Borgesvpm/Amaze/Data visualization/189003_decision_timing_1.png

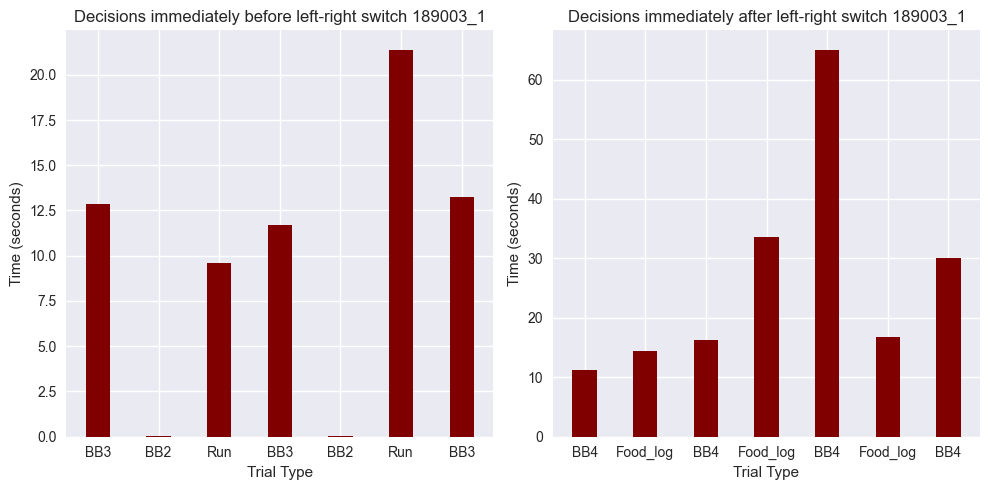
Data visualization/189003_decision_timing_1.png
