Borgesvpm/Amaze/Data visualization/189003_decision_timing_2.png

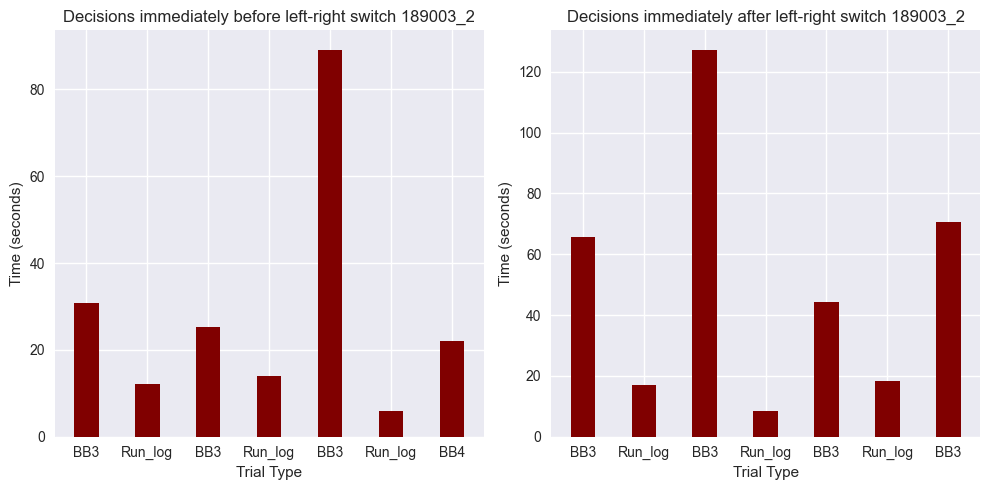
Data visualization/189003_decision_timing_2.png
