Borgesvpm/Amaze/Data visualization/189003_decision_timing_3.png

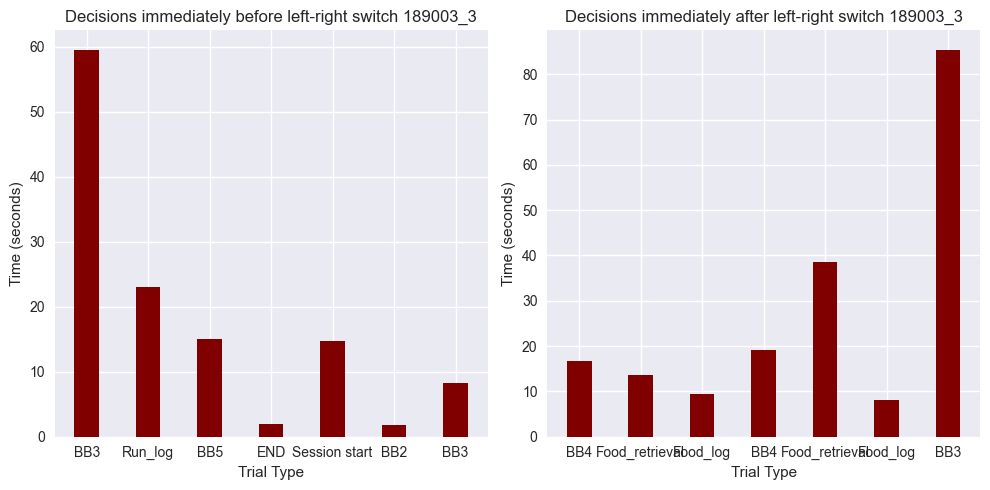
Data visualization/189003_decision_timing_3.png
