Borgesvpm/Amaze/Data visualization/189003_decision_timing_4.png

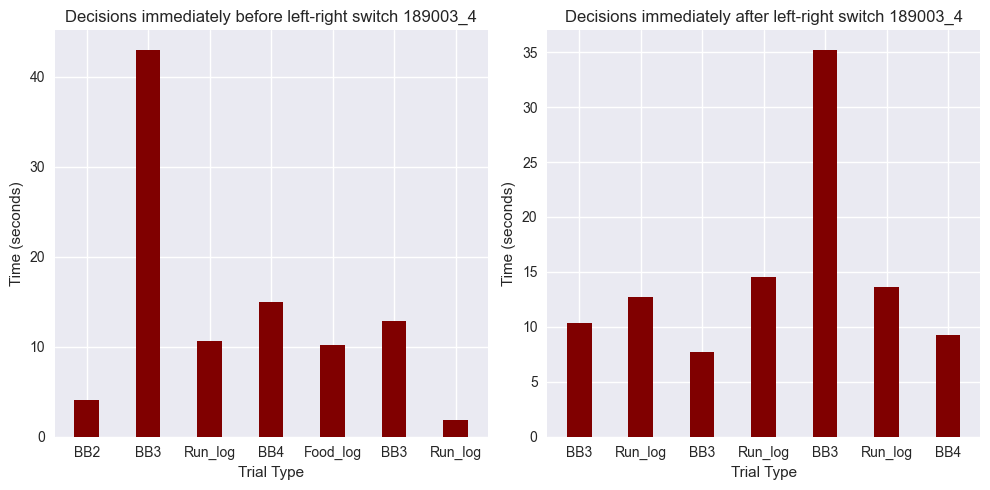
Data visualization/189003_decision_timing_4.png
