Borgesvpm/Amaze/Data visualization/189003_three_decisions.png

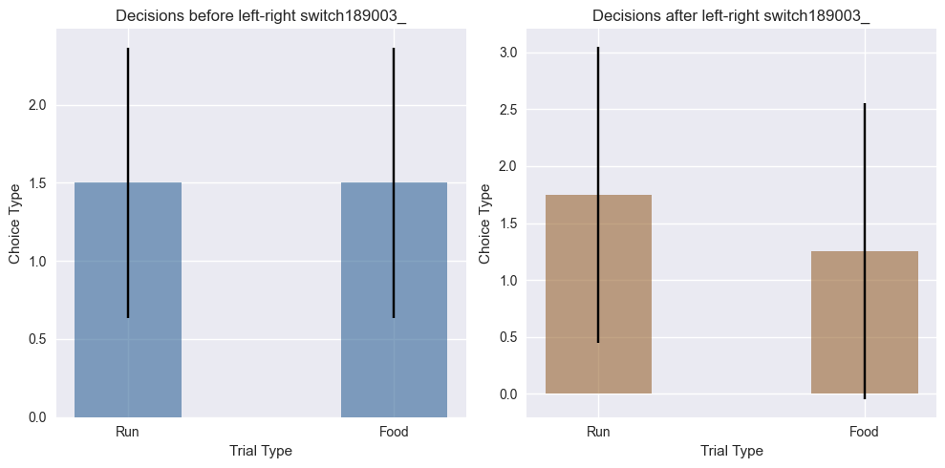
Data visualization/189003_three_decisions.png
