Borgesvpm/Amaze/Data visualization/189003_three_decisions_line.png

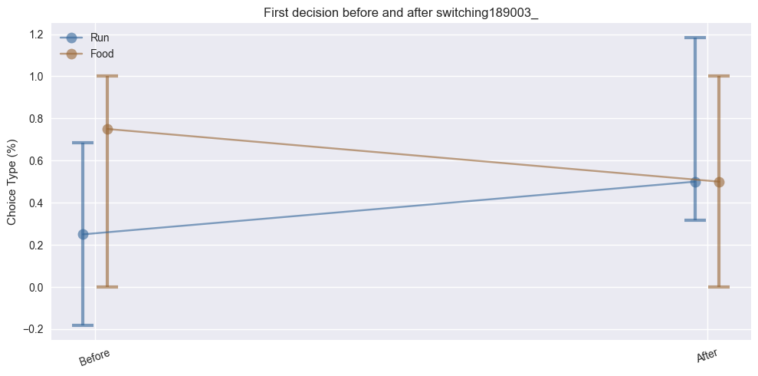
Data visualization/189003_three_decisions_line.png
