Borgesvpm/Amaze/Data visualization/189003_time_stats.png

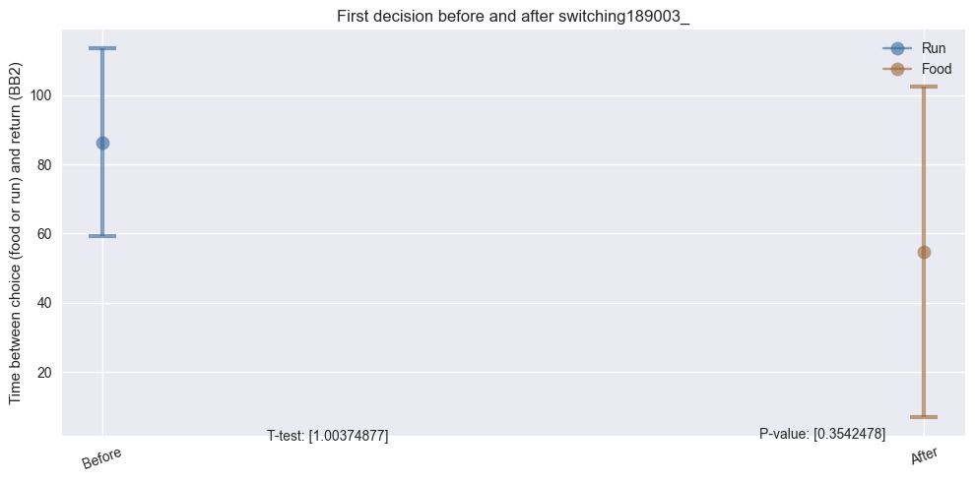
Data visualization/189003_time_stats.png
