Borgesvpm/Amaze/Data visualization/189003day_decision.png

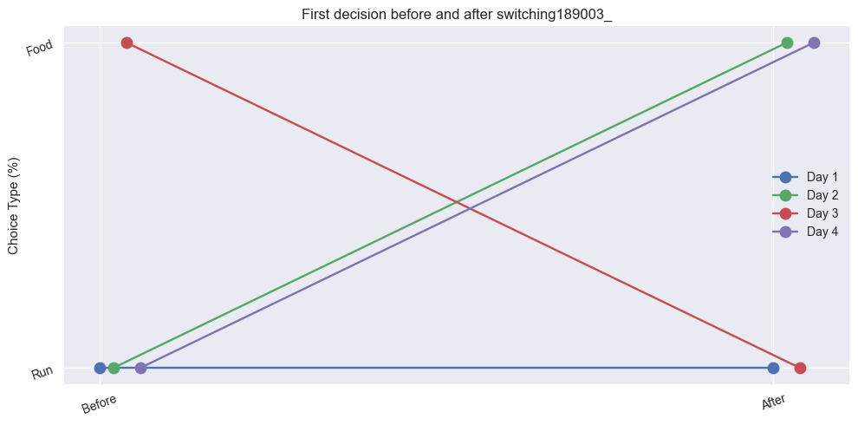
Data visualization/189003day_decision.png
