Borgesvpm/Amaze/Data visualization/189003day_decision_time.png

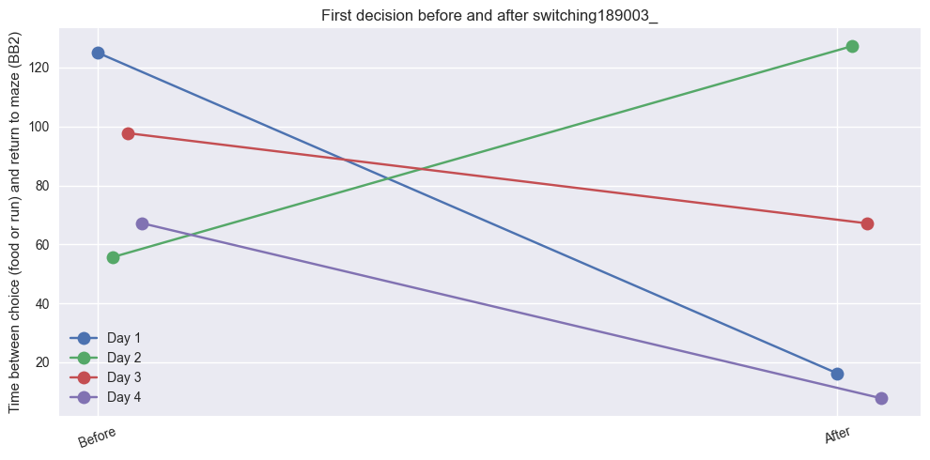
Data visualization/189003day_decision_time.png
