Borgesvpm/Amaze/Data visualization/189004_decision_timing_1.png

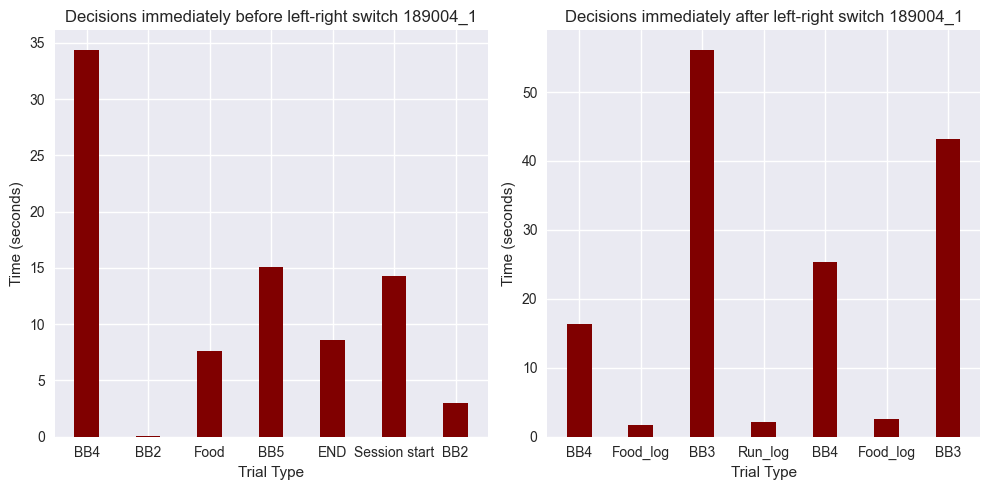
Data visualization/189004_decision_timing_1.png
