Borgesvpm/Amaze/Data visualization/189004_decision_timing_2.png

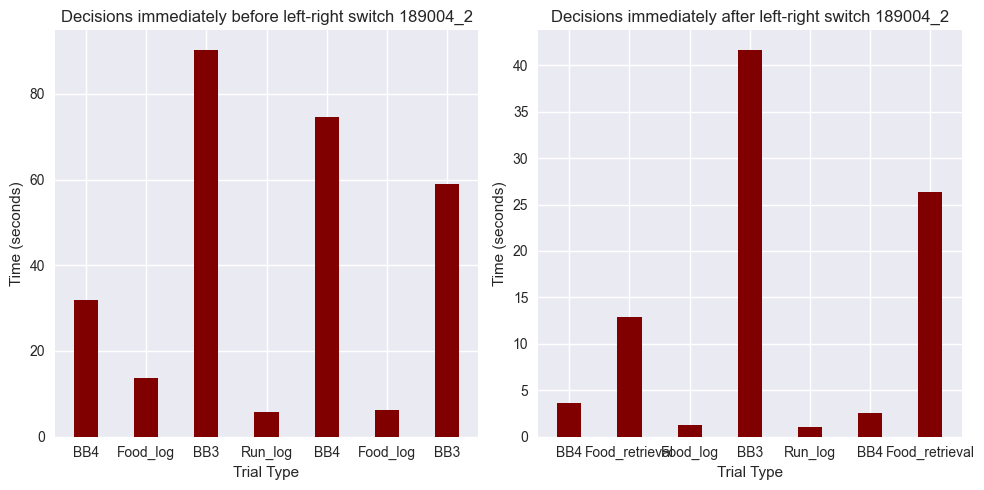
Data visualization/189004_decision_timing_2.png
