Borgesvpm/Amaze/Data visualization/189004_decision_timing_3.png

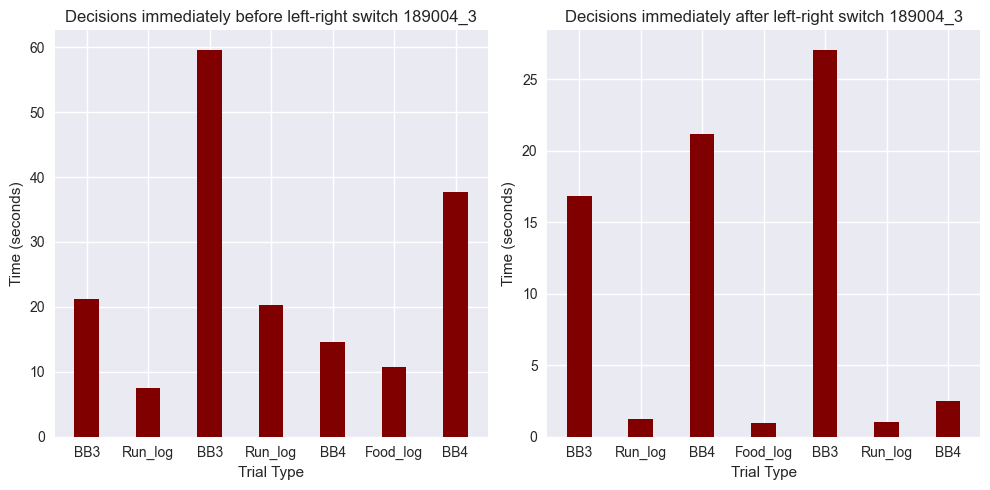
Data visualization/189004_decision_timing_3.png
