Borgesvpm/Amaze/Data visualization/189004_decision_timing_4.png

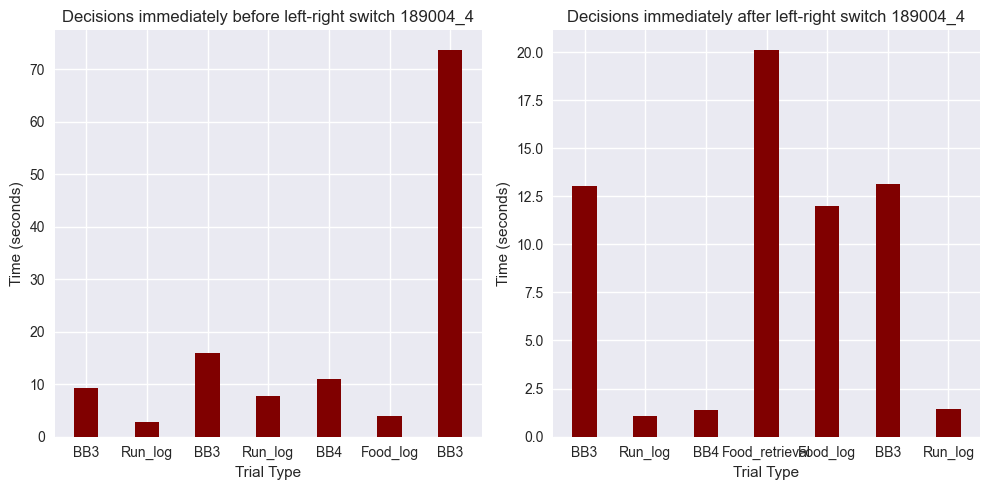
Data visualization/189004_decision_timing_4.png
