Borgesvpm/Amaze/Data visualization/189004_decision_timing_5.png

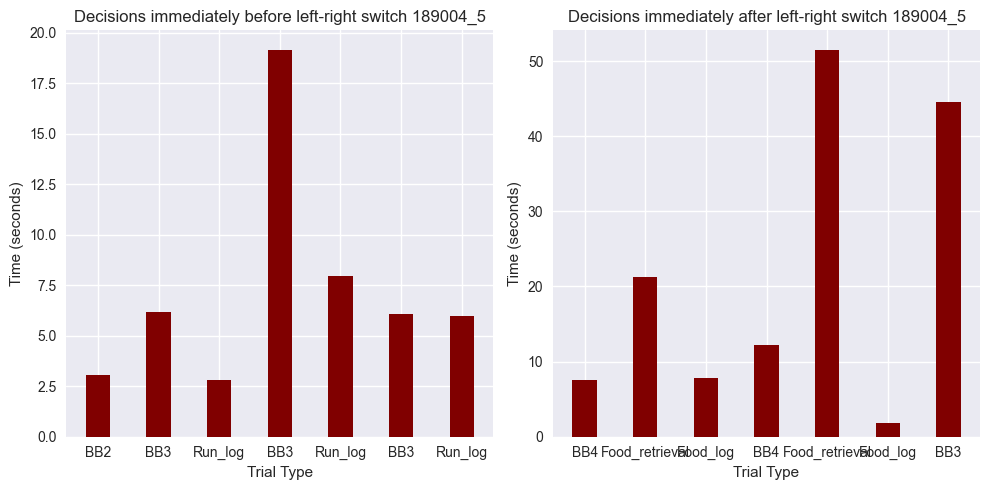
Data visualization/189004_decision_timing_5.png
