Borgesvpm/Amaze/Data visualization/189004_three_decisions.png

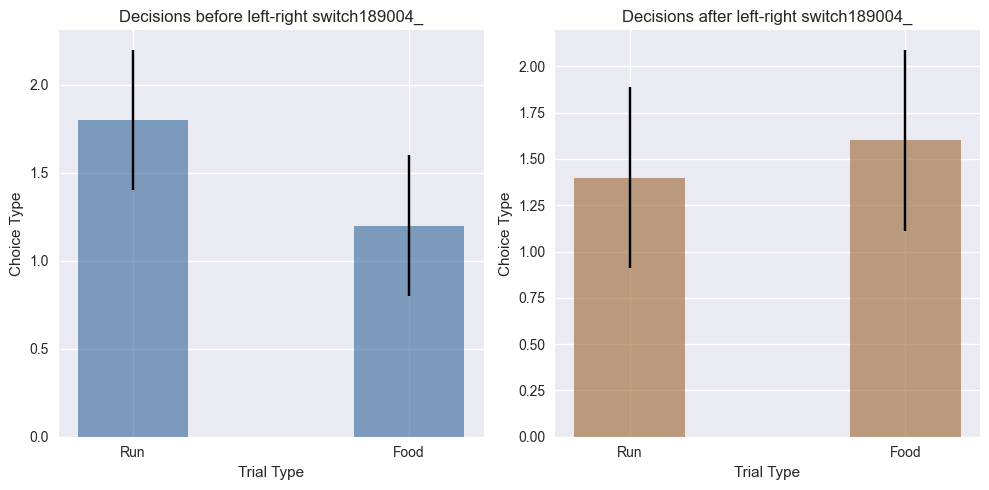
Data visualization/189004_three_decisions.png
