Borgesvpm/Amaze/Data visualization/189004_three_decisions_line.png

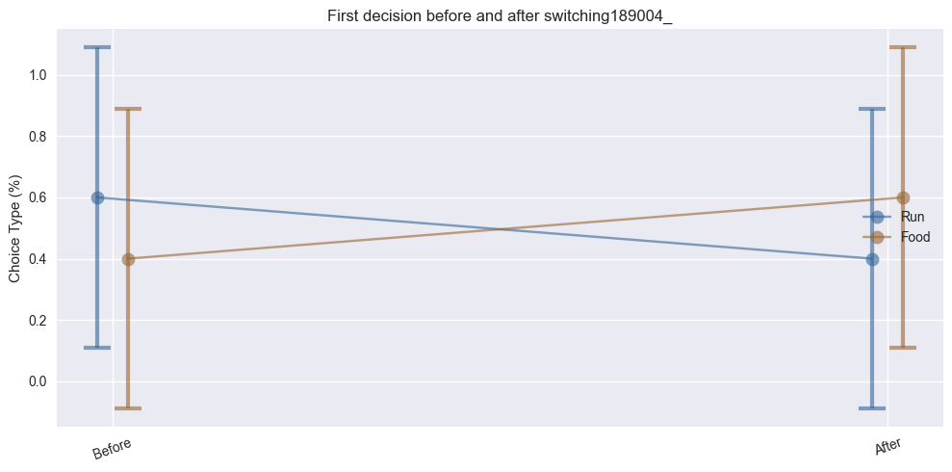
Data visualization/189004_three_decisions_line.png
