Borgesvpm/Amaze/Data visualization/189004_time_stats.png

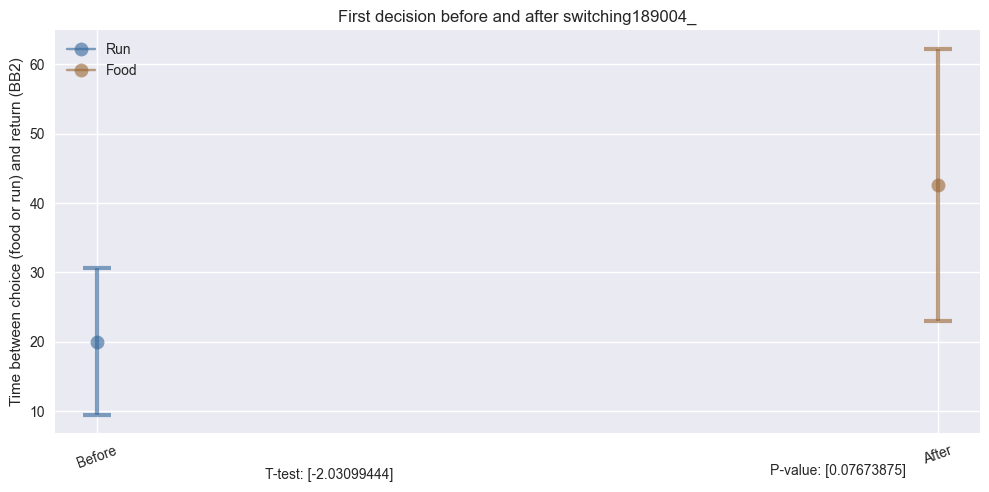
Data visualization/189004_time_stats.png
