Borgesvpm/Amaze/Data visualization/189004day_decision.png

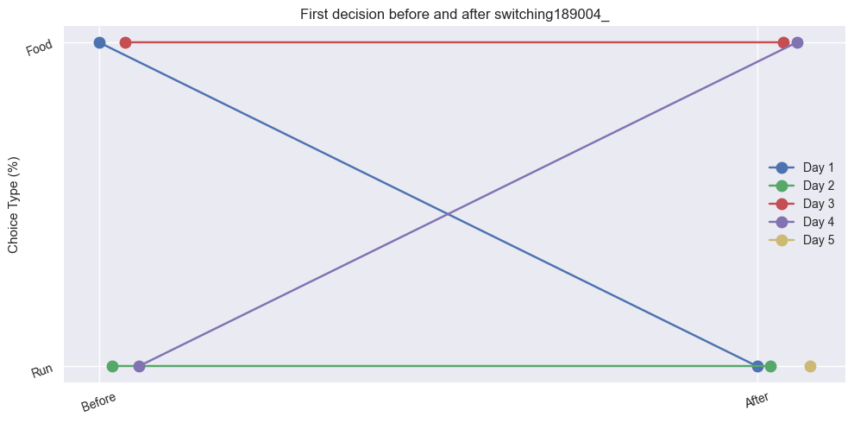
Data visualization/189004day_decision.png
