Borgesvpm/Amaze/Data visualization/189004day_decision_time.png

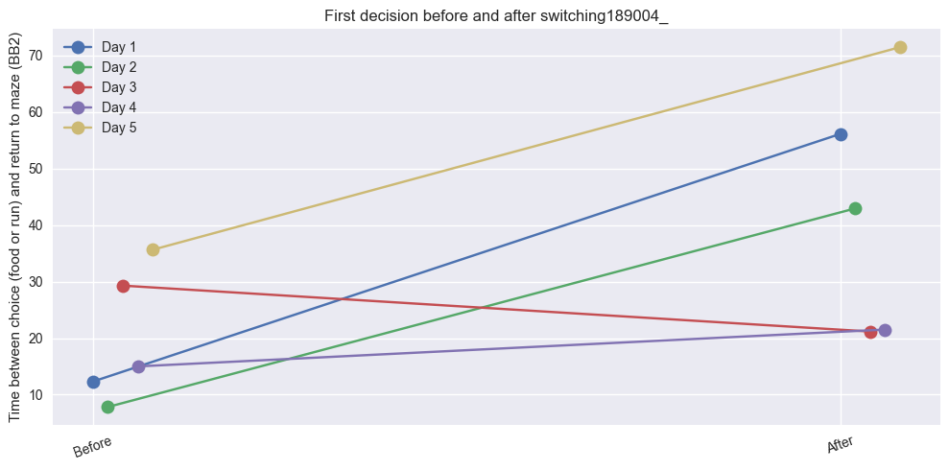
Data visualization/189004day_decision_time.png
