Borgesvpm/Amaze/Data visualization/189005_decision_timing_1.png

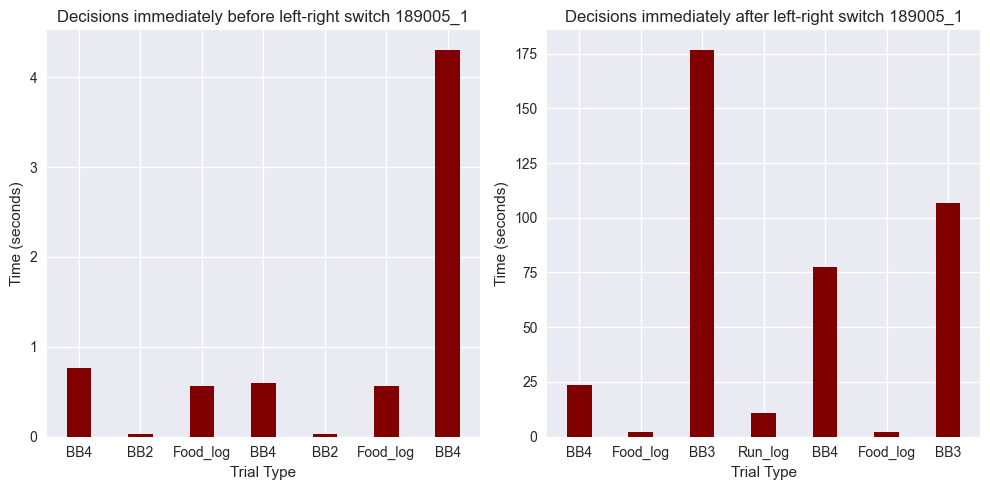
Data visualization/189005_decision_timing_1.png
