Borgesvpm/Amaze/Data visualization/189005_decision_timing_2.png

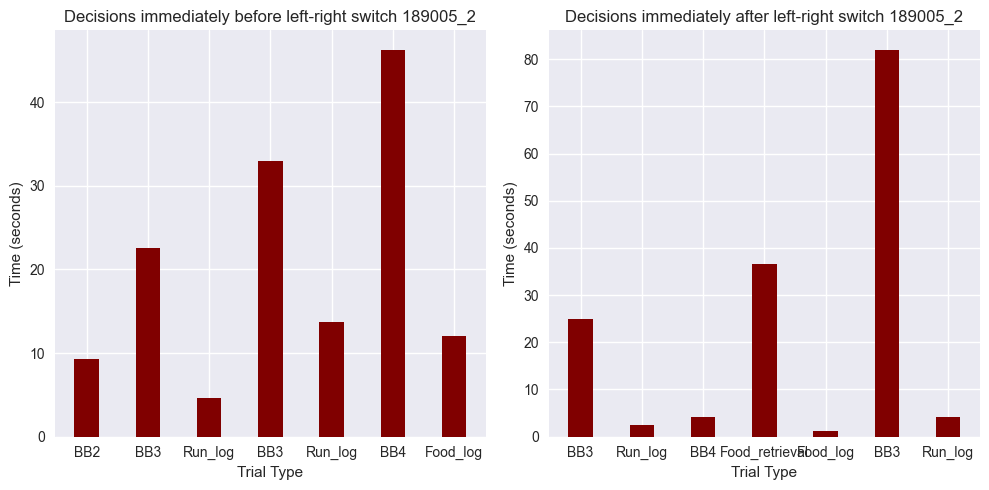
Data visualization/189005_decision_timing_2.png
