Borgesvpm/Amaze/Data visualization/189005_decision_timing_3.png

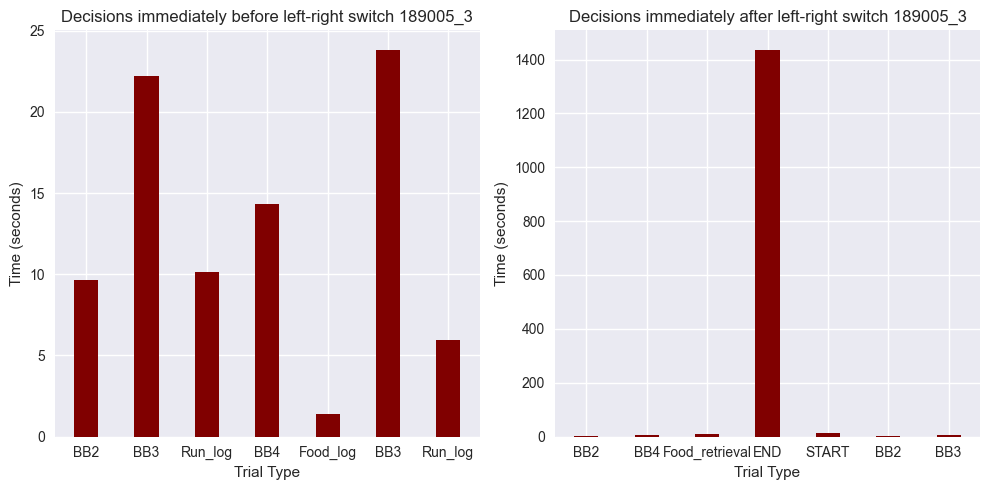
Data visualization/189005_decision_timing_3.png
