Borgesvpm/Amaze/Data visualization/189005_decision_timing_4.png

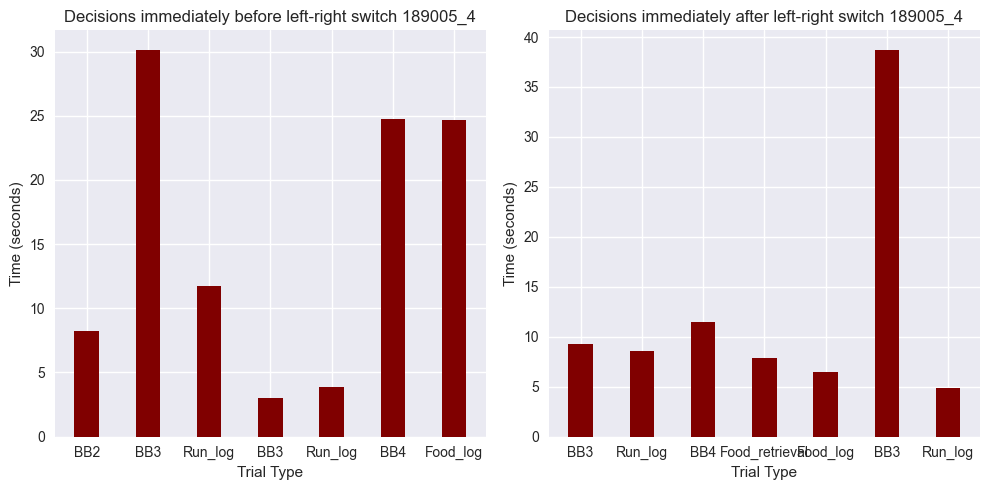
Data visualization/189005_decision_timing_4.png
