Borgesvpm/Amaze/Data visualization/189005_decision_timing_5.png

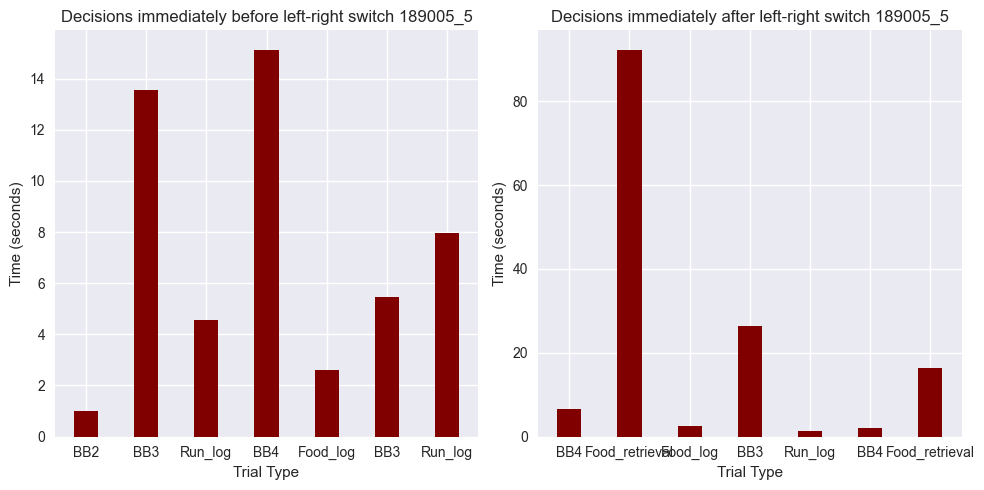
Data visualization/189005_decision_timing_5.png
