Borgesvpm/Amaze/Data visualization/189005_decision_timing_6.png

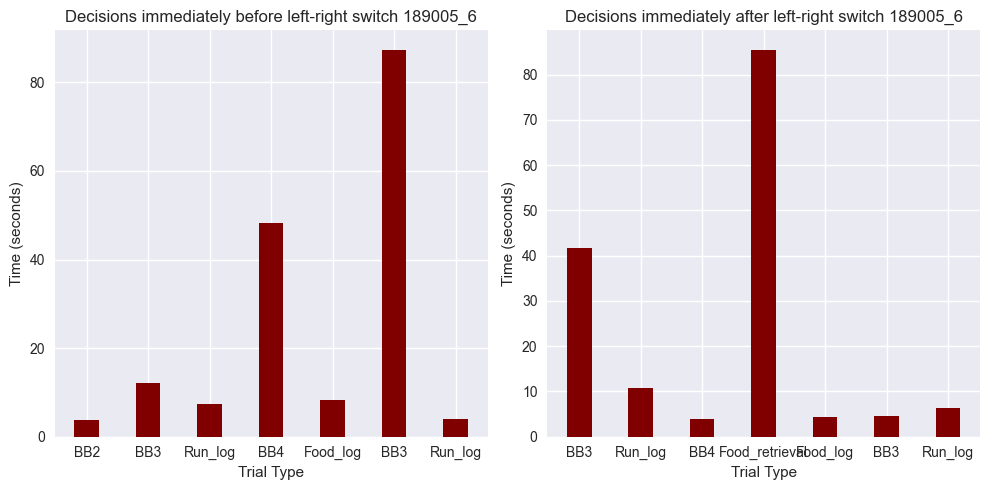
Data visualization/189005_decision_timing_6.png
