Borgesvpm/Amaze/Data visualization/189005_decision_timing_7.png

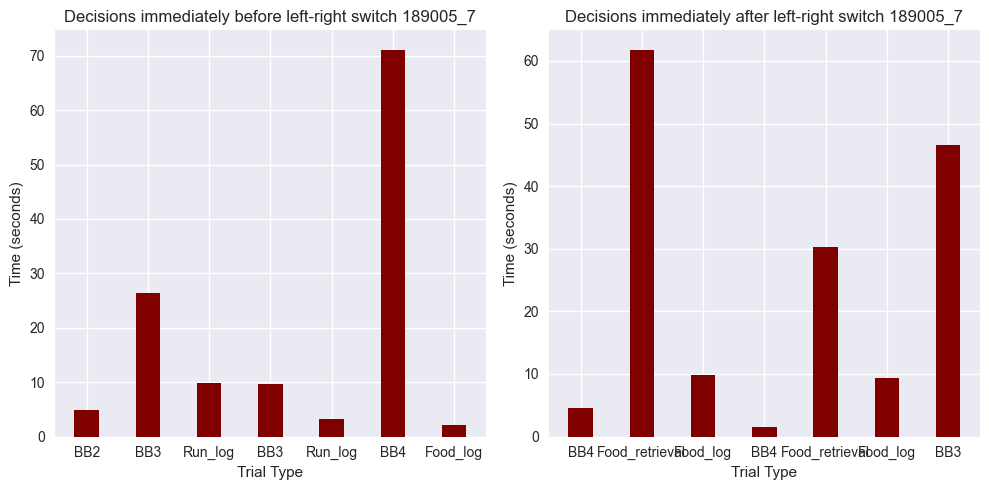
Data visualization/189005_decision_timing_7.png
