Borgesvpm/Amaze/Data visualization/189005_three_decisions_line.png

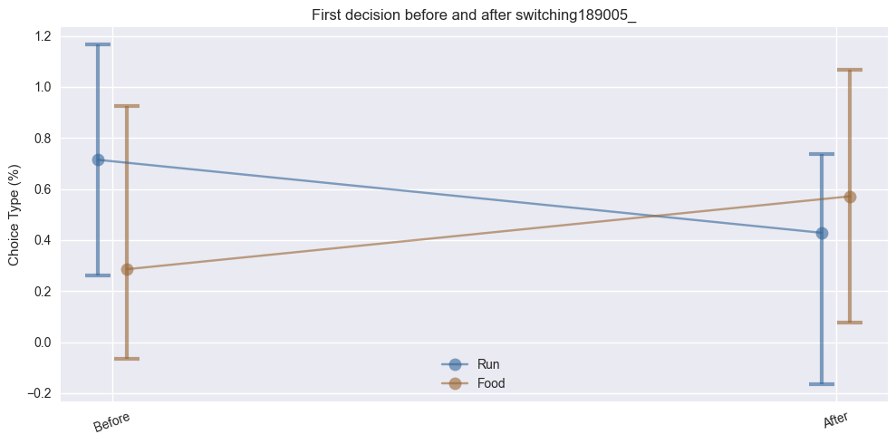
Data visualization/189005_three_decisions_line.png
