Borgesvpm/Amaze/Data visualization/189005_time_stats.png

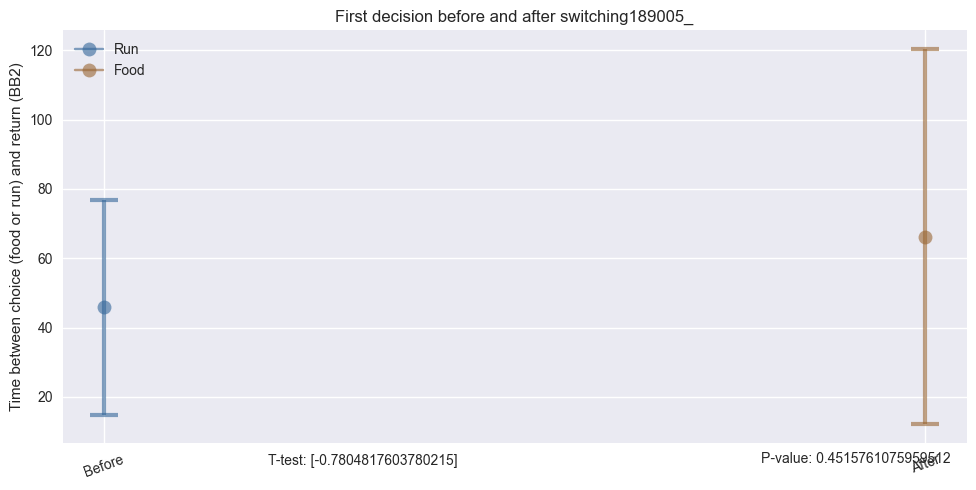
Data visualization/189005_time_stats.png
