Borgesvpm/Amaze/Data visualization/189005_time_stats_outlier_removed.png

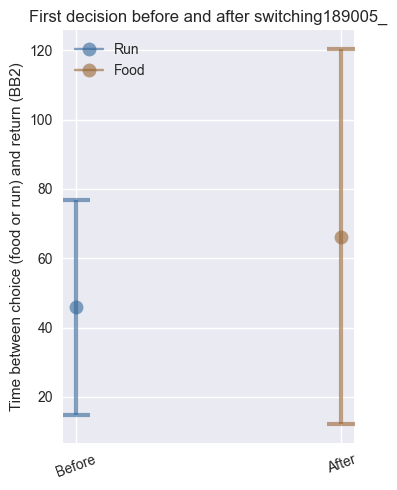
Data visualization/189005_time_stats_outlier_removed.png
