Borgesvpm/Amaze/Data visualization/189005day_decision.png

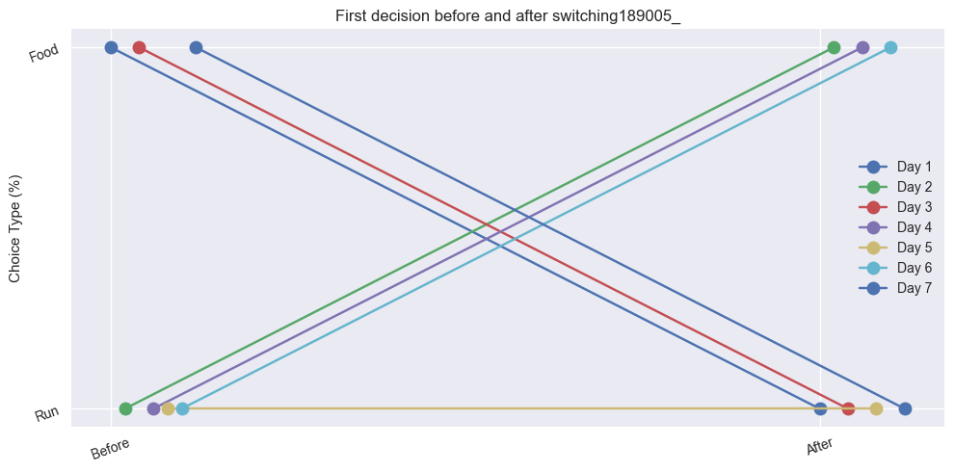
Data visualization/189005day_decision.png
