Borgesvpm/Amaze/Data visualization/189005day_decision_time.png

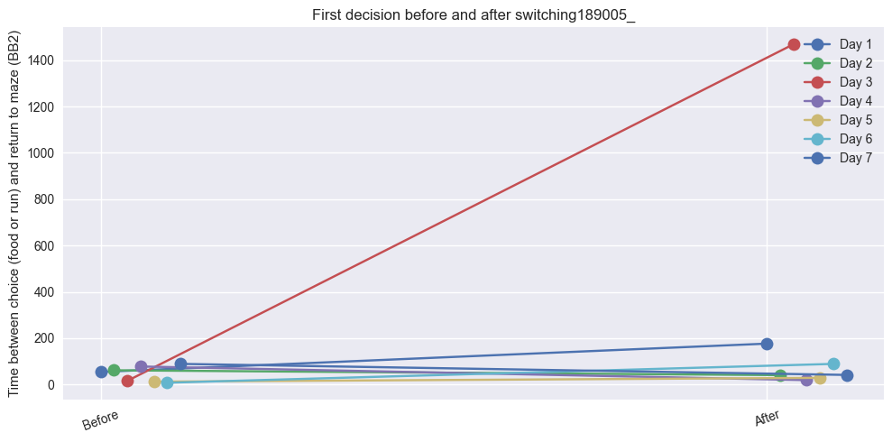
Data visualization/189005day_decision_time.png
