Borgesvpm/Amaze/RFID_scale/0220082200D5DF-20201029-043134.png

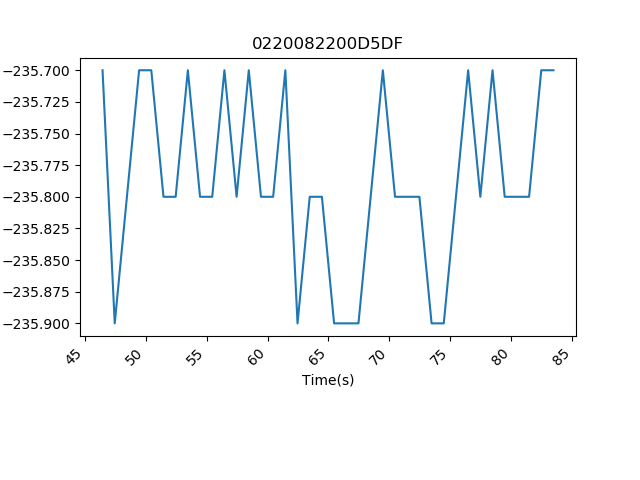
RFID_scale/0220082200D5DF-20201029-043134.png
