Borgesvpm/Amaze/RFID_scale/0220082200D5DF-20201029-050307.png

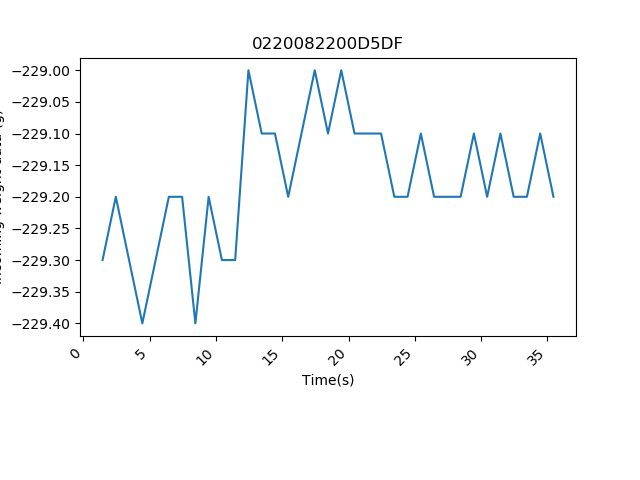
RFID_scale/0220082200D5DF-20201029-050307.png
