Borgesvpm/Amaze/Tmaze_ARD/Illustrations/Layout maze.png

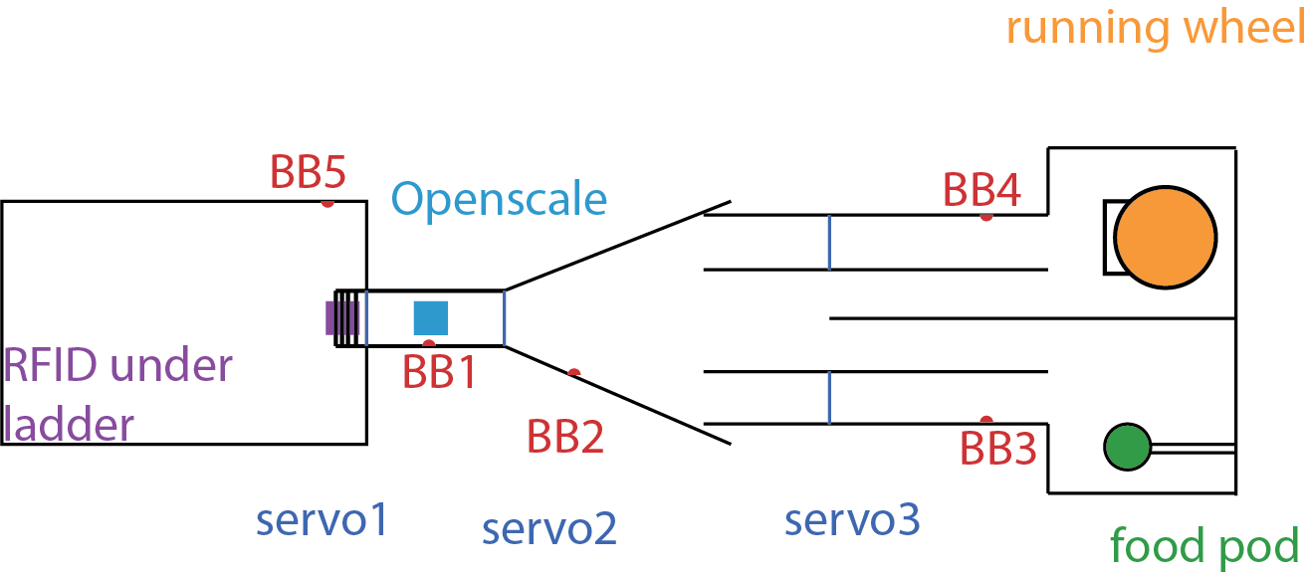
Tmaze_ARD/Illustrations/Layout maze.png
