Borgesvpm/Amaze/Tmaze_ARD/Illustrations/mode1.png

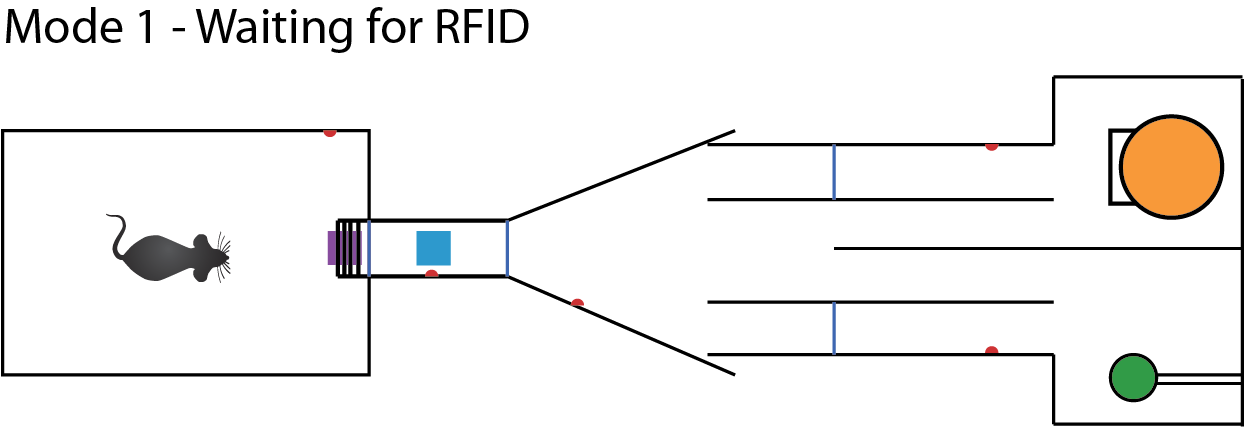
Tmaze_ARD/Illustrations/mode1.png
