Borgesvpm/Amaze/Tmaze_ARD/Illustrations/mode2_triggered.png

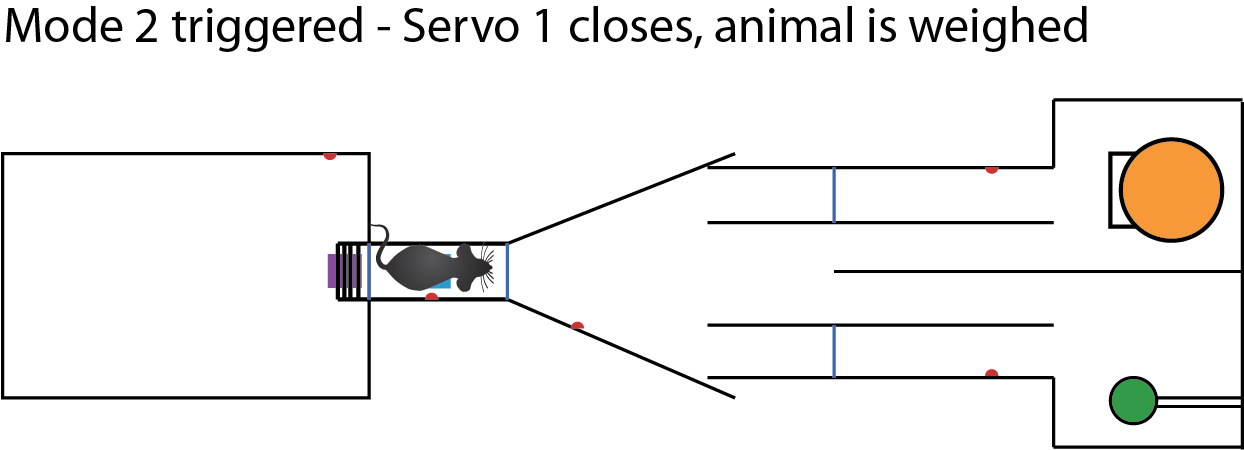
Tmaze_ARD/Illustrations/mode2_triggered.png
