Borgesvpm/Amaze/Tmaze_ARD/Illustrations/mode3.png

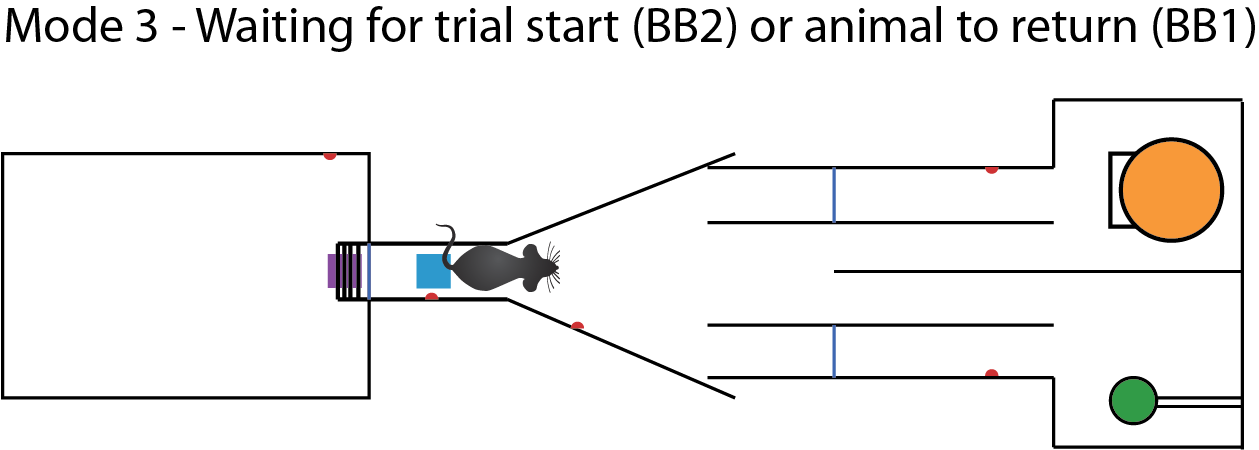
Tmaze_ARD/Illustrations/mode3.png
