Borgesvpm/Amaze/Tmaze_ARD/Illustrations/mode3_food.png

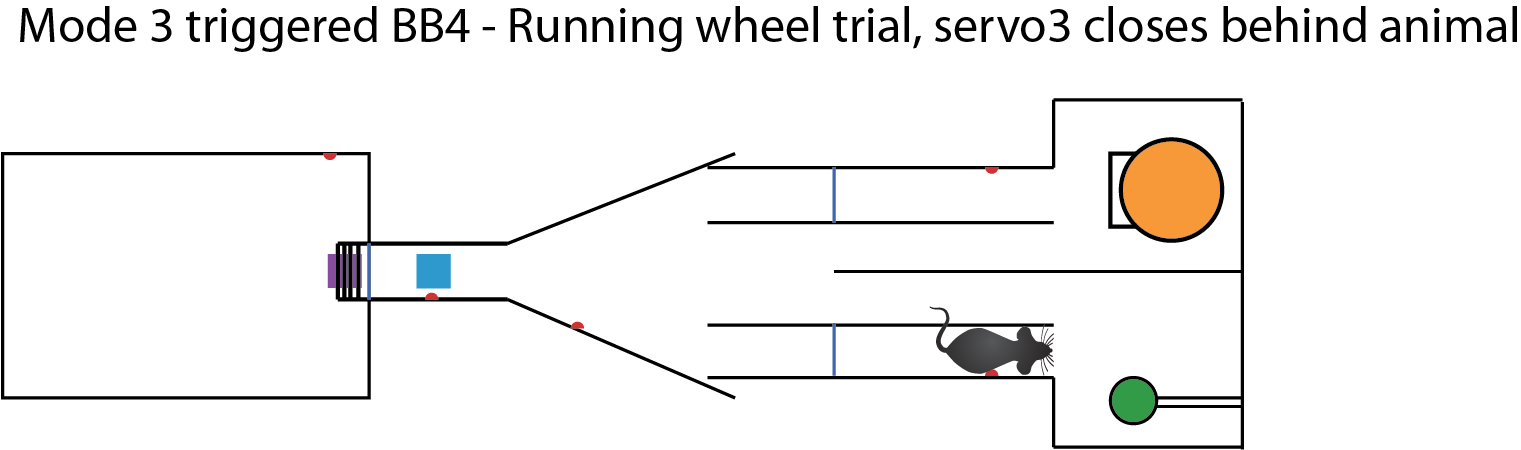
Tmaze_ARD/Illustrations/mode3_food.png
