Borgesvpm/Amaze/Tmaze_ARD/Illustrations/mode3_home.png

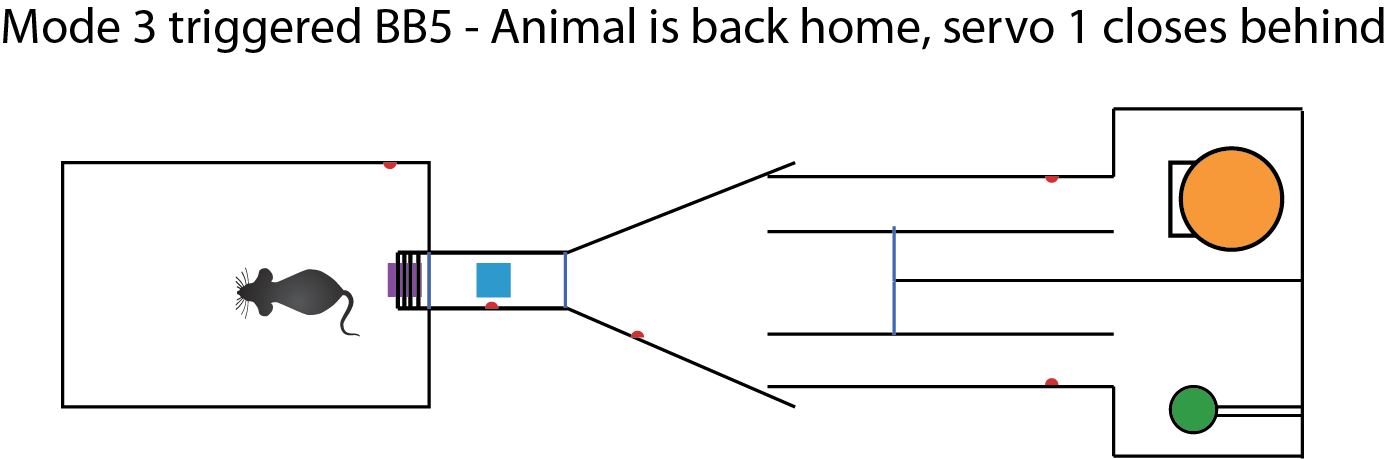
Tmaze_ARD/Illustrations/mode3_home.png
