Borgesvpm/Amaze/Tmaze_ARD/Illustrations/mode3_return.png

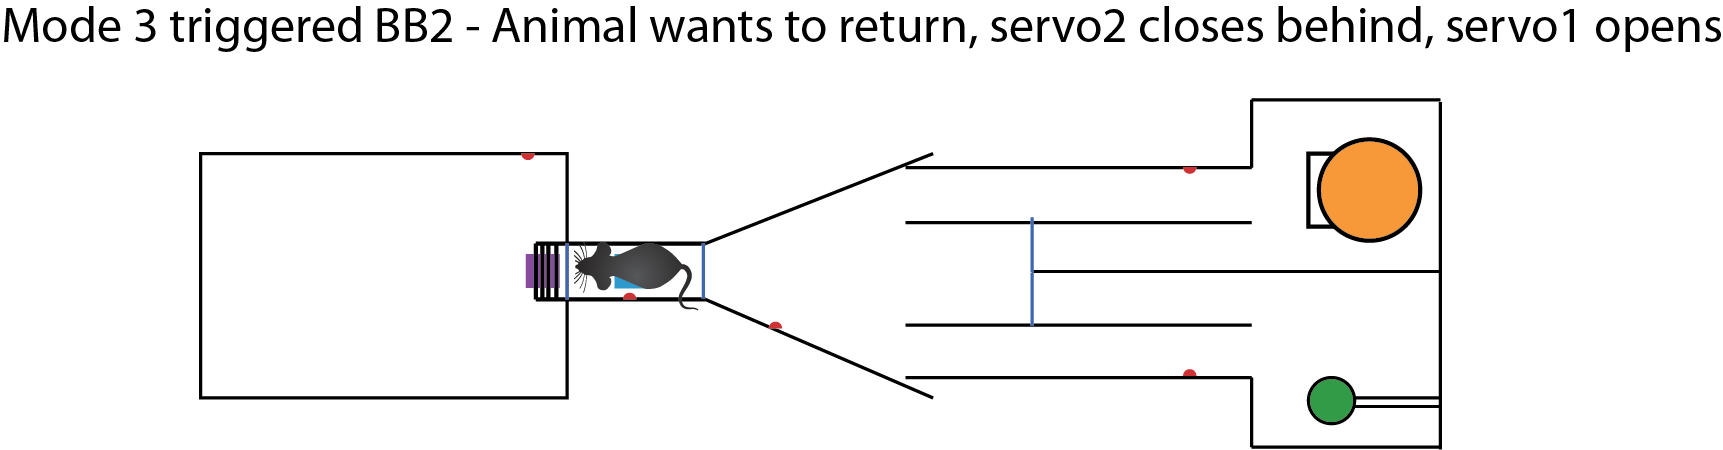
Tmaze_ARD/Illustrations/mode3_return.png
