Borgesvpm/Amaze/Tmaze_ARD/Illustrations/mode3_wheel.png

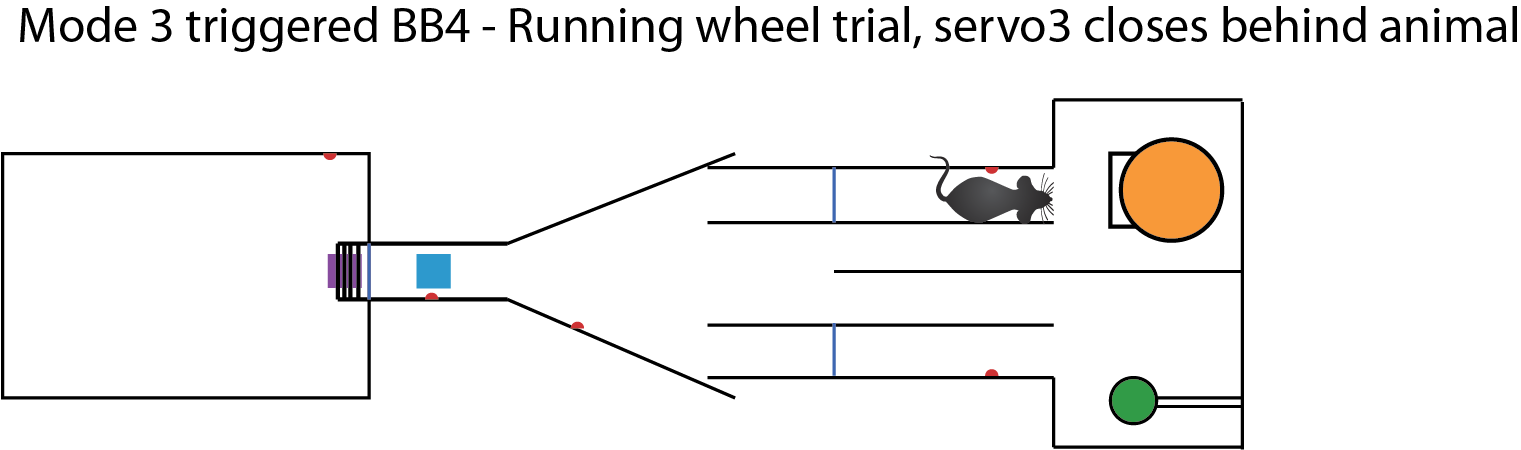
Tmaze_ARD/Illustrations/mode3_wheel.png
