Borgesvpm/Amaze/3D printing/Fantabulous Waasa-Juttuli.stl

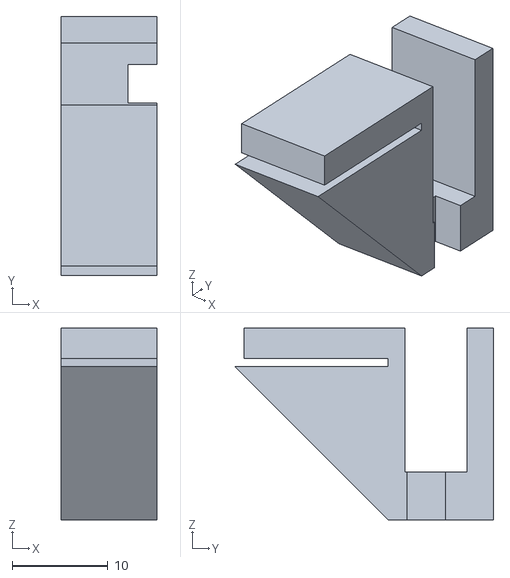
[picture p44: CAD file, 2021-03-25]
3D printing/Fantabulous Waasa-Juttuli.stl
10.0 x 27.0 x 20.0
