Borgesvpm/Amaze/3D printing/slit3door1.stl

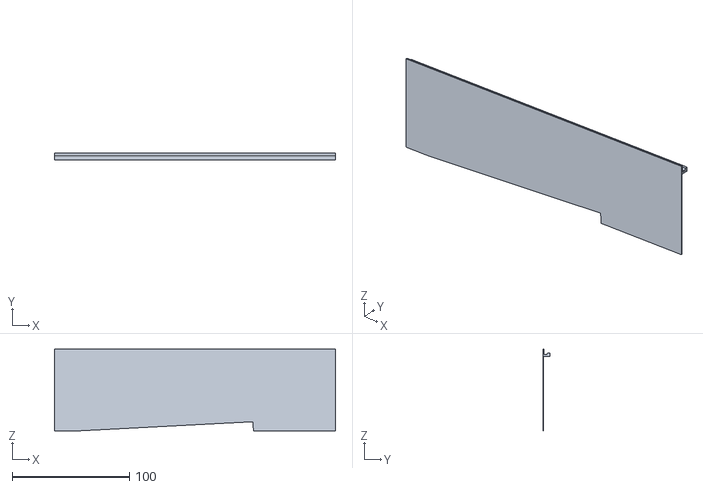
[picture p45: CAD file, 2021-03-24]
3D printing/slit3door1.stl
240.0 x 6.00 x 70.0
