Borgesvpm/Amaze/3D printing/slit_extension.stl

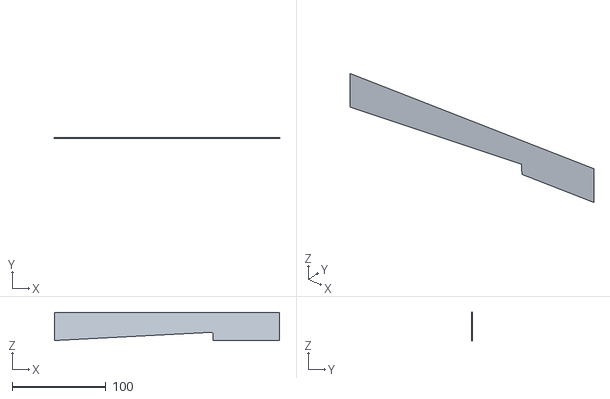
[picture p46: CAD file, 2021-03-24]
3D printing/slit_extension.stl
240.0 x 0.3 x 30.0
