Borgesvpm/Amaze/3D printing/Spectacular Blorr-Jaban.stl

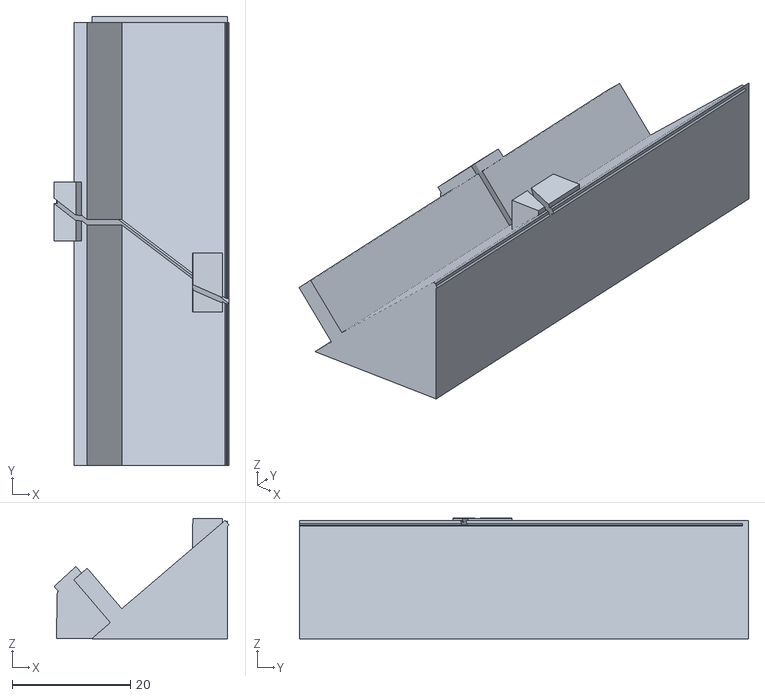
[picture p47: CAD file, 2021-03-22]
3D printing/Spectacular Blorr-Jaban.stl
29.6 x 76.0 x 20.4
