Borgesvpm/Amaze/3D printing/Copy of Grand Bigery-Stantia.stl

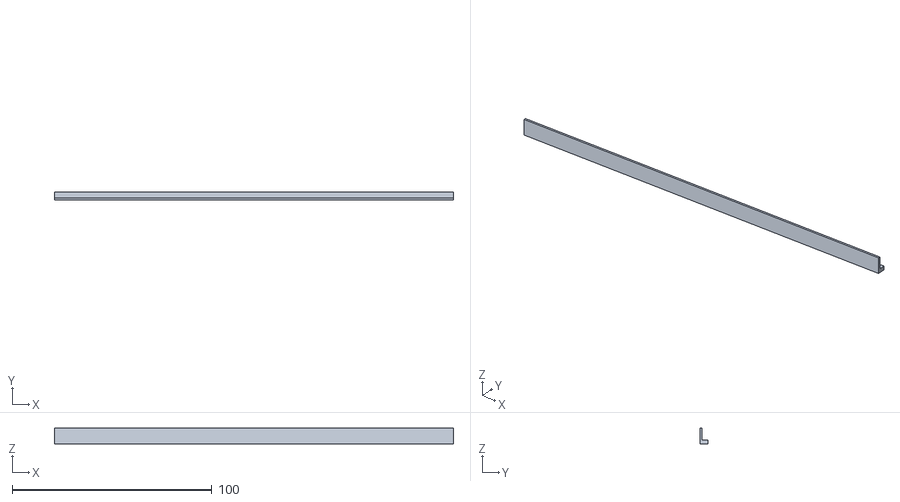
[picture p48: CAD file, 2021-03-22]
3D printing/Copy of Grand Bigery-Stantia.stl
200.0 x 4.00 x 8.00
