Borgesvpm/Amaze/3D printing/door1ceiling.stl

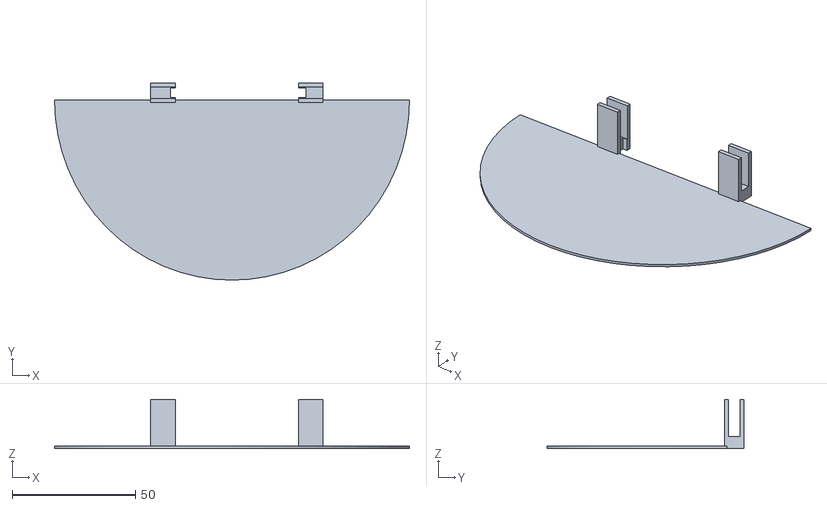
[picture p49: CAD file, 2021-03-16]
3D printing/door1ceiling.stl
144.0 x 80.0 x 20.0
