Borgesvpm/Amaze/3D printing/foodceiling.stl

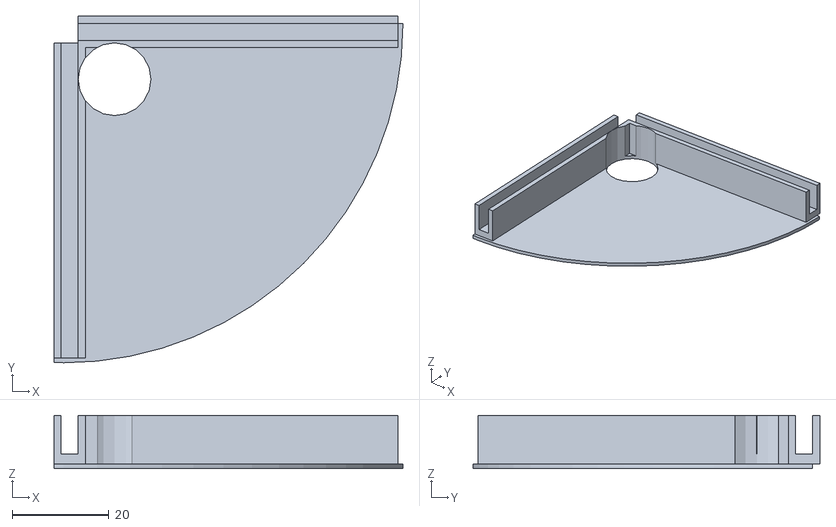
[picture p50: CAD file, 2021-03-16]
3D printing/foodceiling.stl
72.0 x 71.5 x 11.0
