Borgesvpm/Amaze/3D printing/leftslit.stl

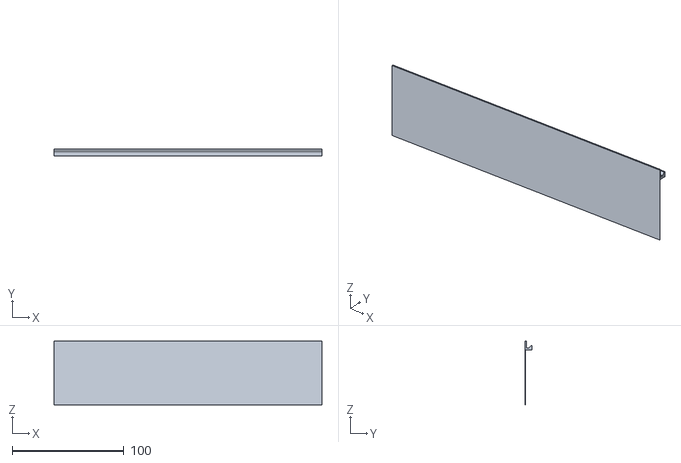
[picture p51: CAD file, 2021-03-14]
3D printing/leftslit.stl
240.0 x 6.00 x 57.0
