Borgesvpm/Amaze/3D printing/cablecorner.stl

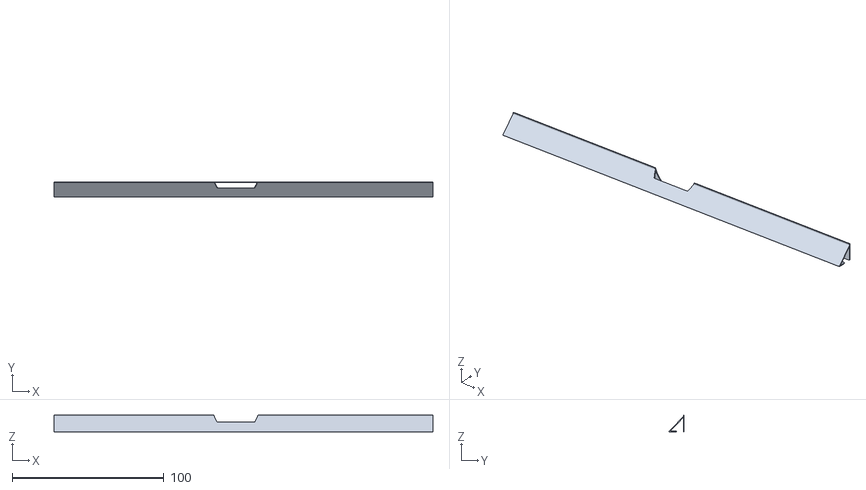
[picture p52: CAD file, 2021-03-13]
3D printing/cablecorner.stl
250.0 x 10.0 x 11.0
