Borgesvpm/Amaze/3D printing/longslit.stl

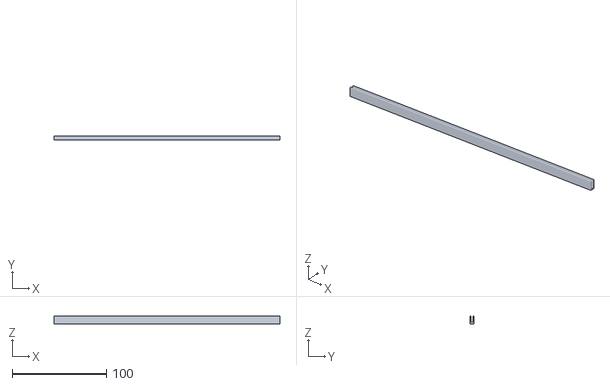
[picture p53: CAD file, 2021-03-13]
3D printing/longslit.stl
240.0 x 4.00 x 8.00
