Borgesvpm/Amaze/3D printing/bigdoor1_1.stl

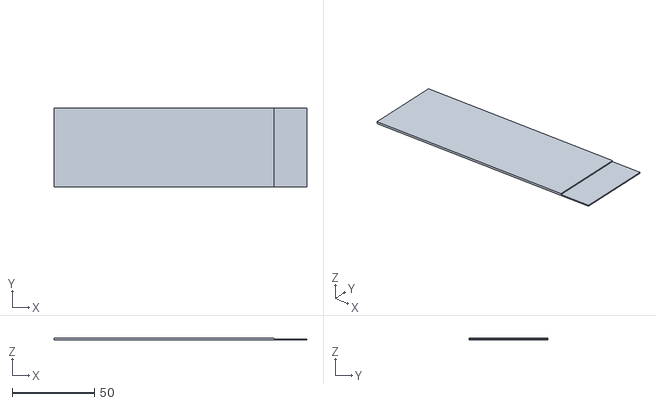
[picture p54: CAD file, 2021-03-13]
3D printing/bigdoor1_1.stl
154.0 x 48.0 x 1.30
