Borgesvpm/Amaze/3D printing/bigdoor1_2.stl

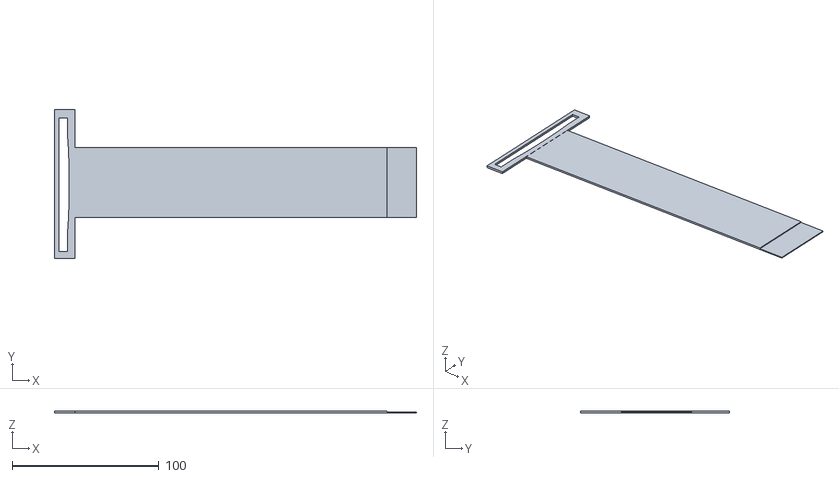
[picture p55: CAD file, 2021-03-13]
3D printing/bigdoor1_2.stl
247.0 x 102.0 x 1.50
