Borgesvpm/Amaze/3D printing/Grand Bigery-Stantia.stl

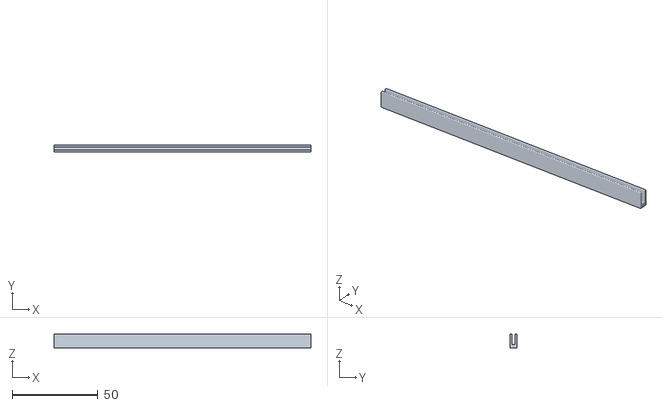
[picture p56: CAD file, 2021-03-12]
3D printing/Grand Bigery-Stantia.stl
150.0 x 4.00 x 8.00
