Borgesvpm/Amaze/3D printing/Door.stl

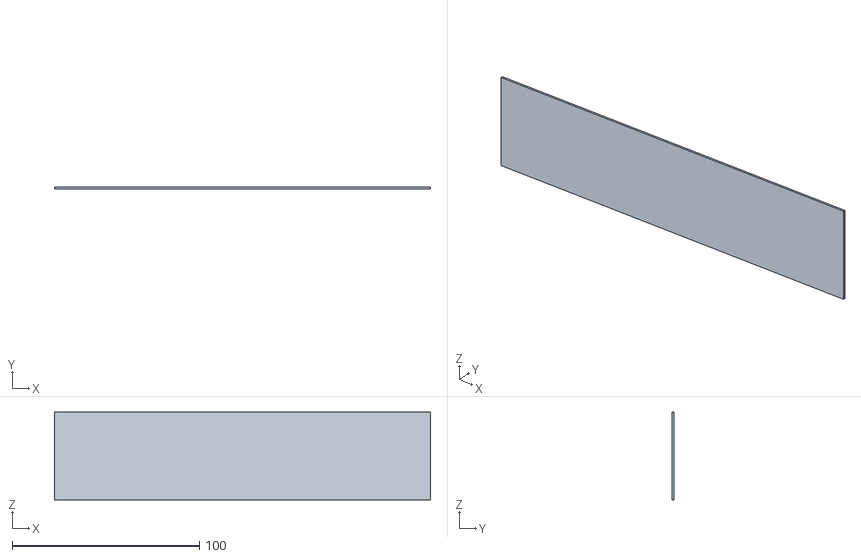
[picture p57: CAD file, 2020-11-06]
3D printing/Door.stl
201.0 x 1 x 47.0
