Borgesvpm/Amaze/3D printing/weighing bridge.stl

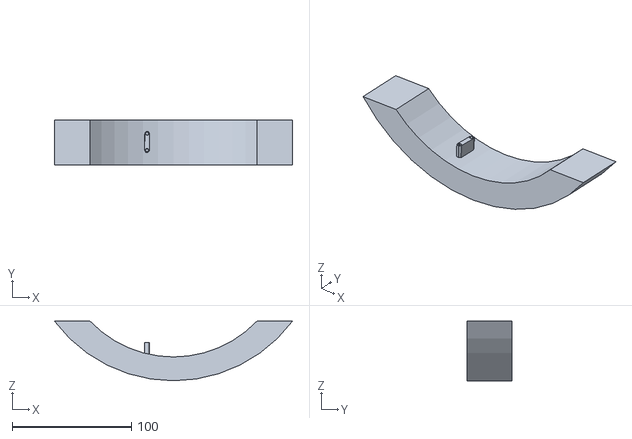
[picture p58: CAD file, 2020-11-05]
3D printing/weighing bridge.stl
200.0 x 38.0 x 50.0
