Borgesvpm/Amaze/3D printing/hook ladder.stl

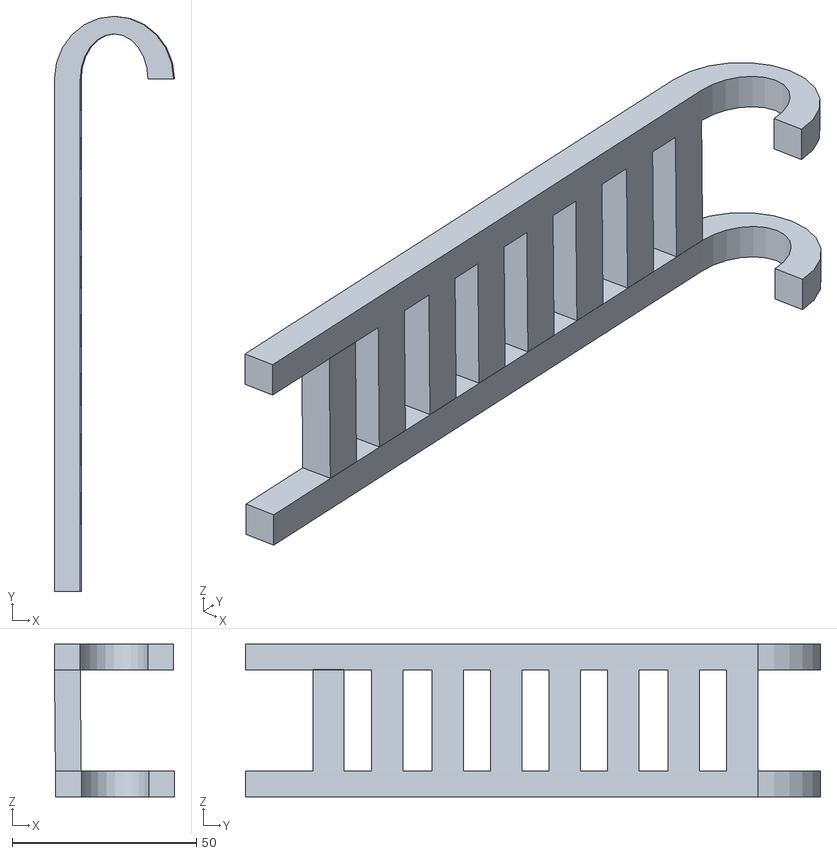
[picture p59: CAD file, 2020-11-04]
3D printing/hook ladder.stl
32.6 x 156.0 x 41.5
