Borgesvpm/Amaze/3D printing/ladder_resized.obj

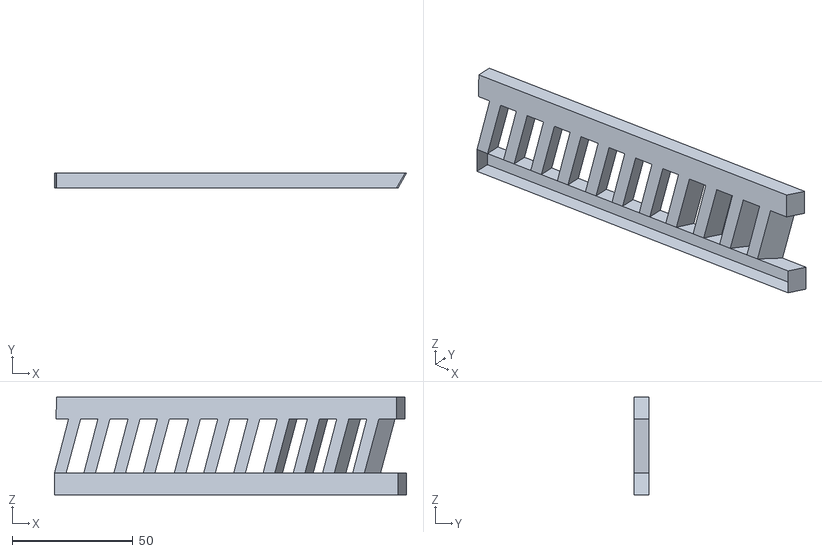
[picture p60: CAD file, 2020-10-30]
3D printing/ladder_resized.obj
145.7 x 6.09 x 40.4
