Borgesvpm/Amaze/3D printing/Ladder.obj

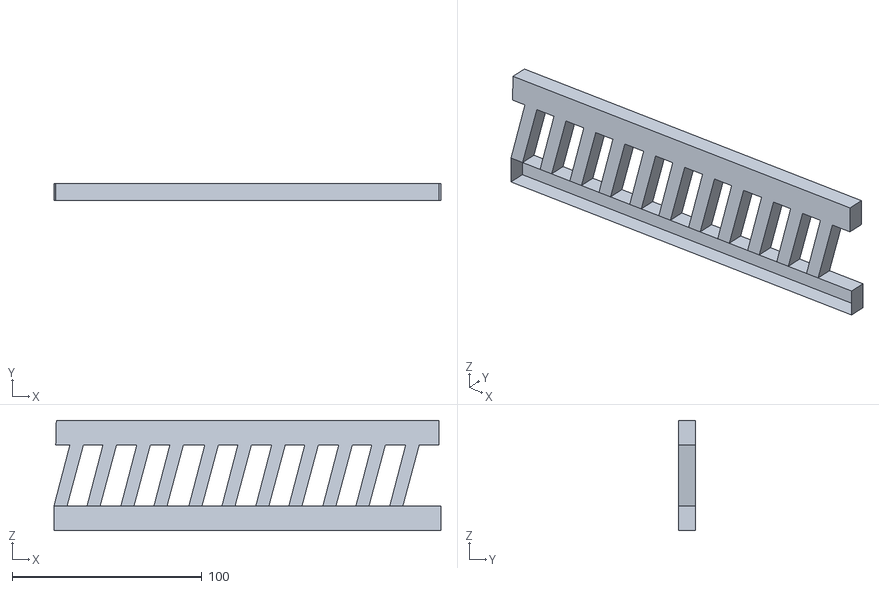
[picture p61: CAD file, 2020-10-30]
3D printing/Ladder.obj
204.2 x 8.75 x 58.1
