Borgesvpm/Amaze/3D printing/Ladder2.obj

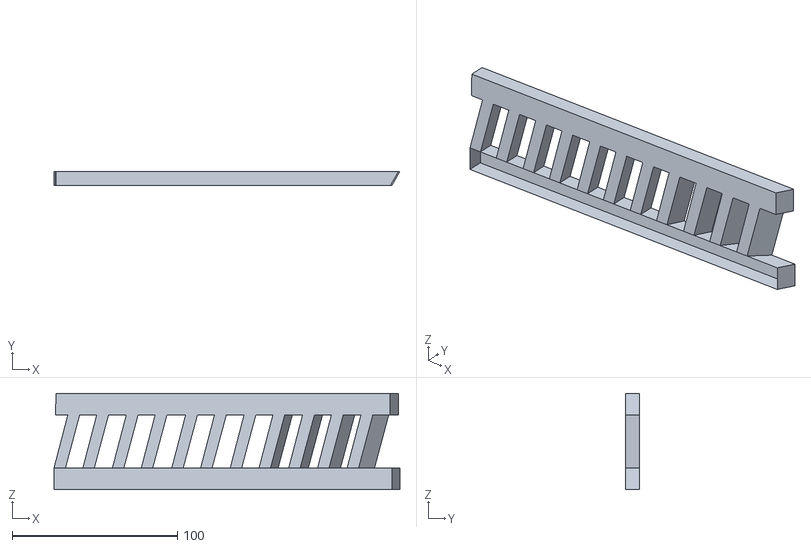
[picture p62: CAD file, 2020-10-30]
3D printing/Ladder2.obj
209.1 x 8.75 x 58.1
