Borgesvpm/Amaze/(list of files, cad)

Other CAD files:
3D printing/runceiling.stl
3D printing/Door.obj
3D printing/Door.skp
3D printing/Fantabulous Waasa-Juttuli(1).stl
3D printing/Fantabulous Waasa-Juttuli(2).stl
3D printing/Ladder.skp
3D printing/Spectacular Blorr-Jaban(1).stl
3D printing/hook ladder.dwg
3D printing/hook ladder.dxf
3D printing/hook ladder.obj
3D printing/hook ladder.skp
3D printing/weighing bridge.obj
