Borgesvpm/Amaze/Test_new_scripts/Amaze_db.csv

Animal | Triggered by | Event | Time | Date
[] | RFID | Session started | 14:48:31.131302 | 2021-02-05
[] | Beam Break 1 | Weight = 15.955000000000002 | 14:48:43.458144 | 2021-02-05
[] | Beam Break 2 | Run cycles = 0.0 | 14:48:45.626990 | 2021-02-05
[] | Beam Break 3 | Return to homecage | 14:49:38.294483 | 2021-02-05
