Borgesvpm/Amaze/OOP/Data_without_BB/BB_TEST_events.csv

Rotation | Type | Date_Time
+ | Session start | 2021-02-26 17:37:35.716662
* | BB2 | 2021-02-26 17:37:51.206905
* | BB4 | 2021-02-26 17:37:53.329891
0.5433 | Food | 2021-02-26 17:38:13.351526
* | BB2 | 2021-02-26 17:38:16.309413
* | BB5 | 2021-02-26 17:38:21.310977
0.4883 | Run | 2021-02-26 17:38:41.332665
* | BB2 | 2021-02-26 17:38:43.614359
* | BB5 | 2021-02-26 17:38:45.906614
- | END | 2021-02-26 17:39:00.943307
