Borgesvpm/Amaze/OOP/Data_without_BB/BB_TEST_weight.csv

Weight_Mean | Weight_Median | Weight_Mode | Date_Time
0.0 | -0.0 | -0.0 | 2021-02-26 17:37:48.563348
