Borgesvpm/Amaze/OOP/Data_without_BB/test_IDE_events.csv

Rotation | Type | Date_Time
+ | START | 2021-02-25 17:49:16.129824
0.1917 | Food | 2021-02-25 17:49:40.644697
0.1625 | Run | 2021-02-25 17:49:46.706888
- | END | 2021-02-25 17:49:50.189038
+ | START | 2021-02-25 18:09:51.941634
0.045 | Food | 2021-02-25 18:10:09.466973
0.0425 | Run | 2021-02-25 18:10:14.193771
- | END | 2021-02-25 18:10:16.545696
