Borgesvpm/Amaze/OOP/Data_without_BB/test_IDE_weight.csv

Weight_Mean | Weight_Median | Weight_Mode | Date_Time
0.0 | -0.0 | 0.0 | 2021-02-25 17:49:28.883464
0.0 | 0.0 | -0.0 | 2021-02-25 18:10:04.730954
