Borgesvpm/Amaze/OOP/Data_without_BB/test_console_events.csv

Rotation | Type | Date_Time
+ | START | 2021-02-25 18:01:51.946149
0.495 | Food | 2021-02-25 18:02:12.496925
0.915 | Run | 2021-02-25 18:02:19.302979
- | END | 2021-02-25 18:02:22.973554
+ | START | 2021-02-25 18:06:02.334745
0.5167 | Food | 2021-02-25 18:06:21.571199
0.5875 | Run | 2021-02-25 18:06:25.284213
- | END | 2021-02-25 18:06:28.432270
+ | START | 2021-02-25 18:08:30.354740
0.5058 | Food | 2021-02-25 18:08:48.651019
0.4967 | Run | 2021-02-25 18:08:51.670220
- | END | 2021-02-25 18:08:54.473324
