Borgesvpm/Amaze/OOP/Data_without_BB/test_console_weight.csv

Weight_Mean | Weight_Median | Weight_Mode | Date_Time
0.0 | -0.0 | 0.0 | 2021-02-25 18:02:04.744082
0.0 | 0.0 | 0.0 | 2021-02-25 18:06:15.274953
0.0 | 0.0 | 0.0 | 2021-02-25 18:08:43.233226
