Borgesvpm/Amaze/OOP/Data_without_BB/benchmark_console.png

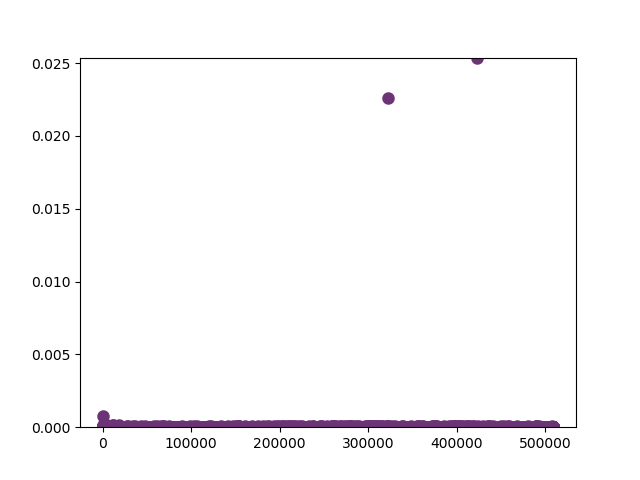
OOP/Data_without_BB/benchmark_console.png
