Borgesvpm/Amaze/OOP/Data_without_BB/benchmark_IDE.png

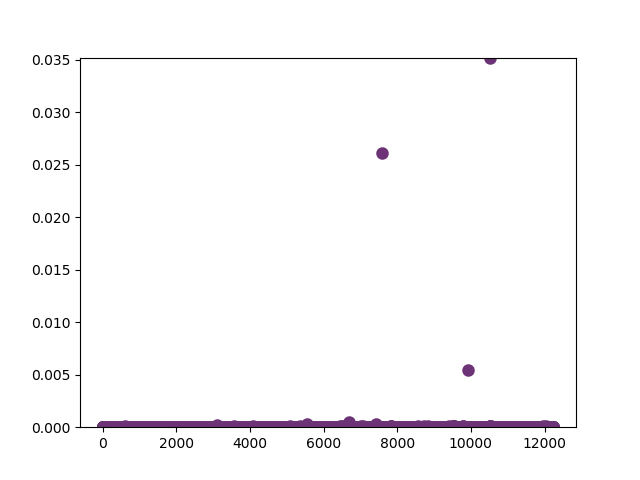
OOP/Data_without_BB/benchmark_IDE.png
