Borgesvpm/Amaze/OOP/Data_without_BB/benchmark_ide_with_comment_script.png

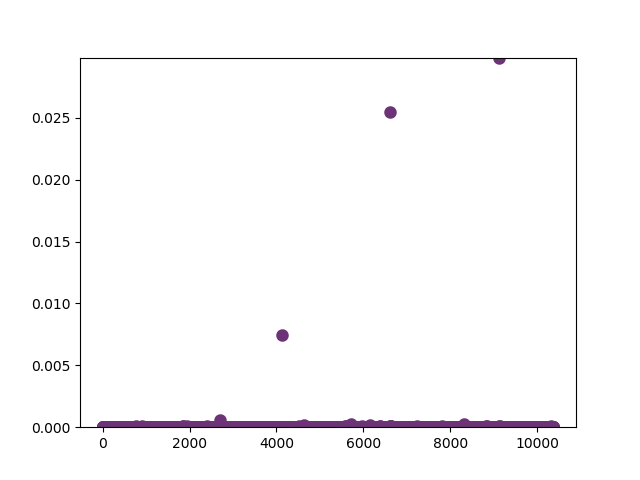
OOP/Data_without_BB/benchmark_ide_with_comment_script.png
