Borgesvpm/Amaze/Schematic_Amaze/Schematic_Amaze.pdf

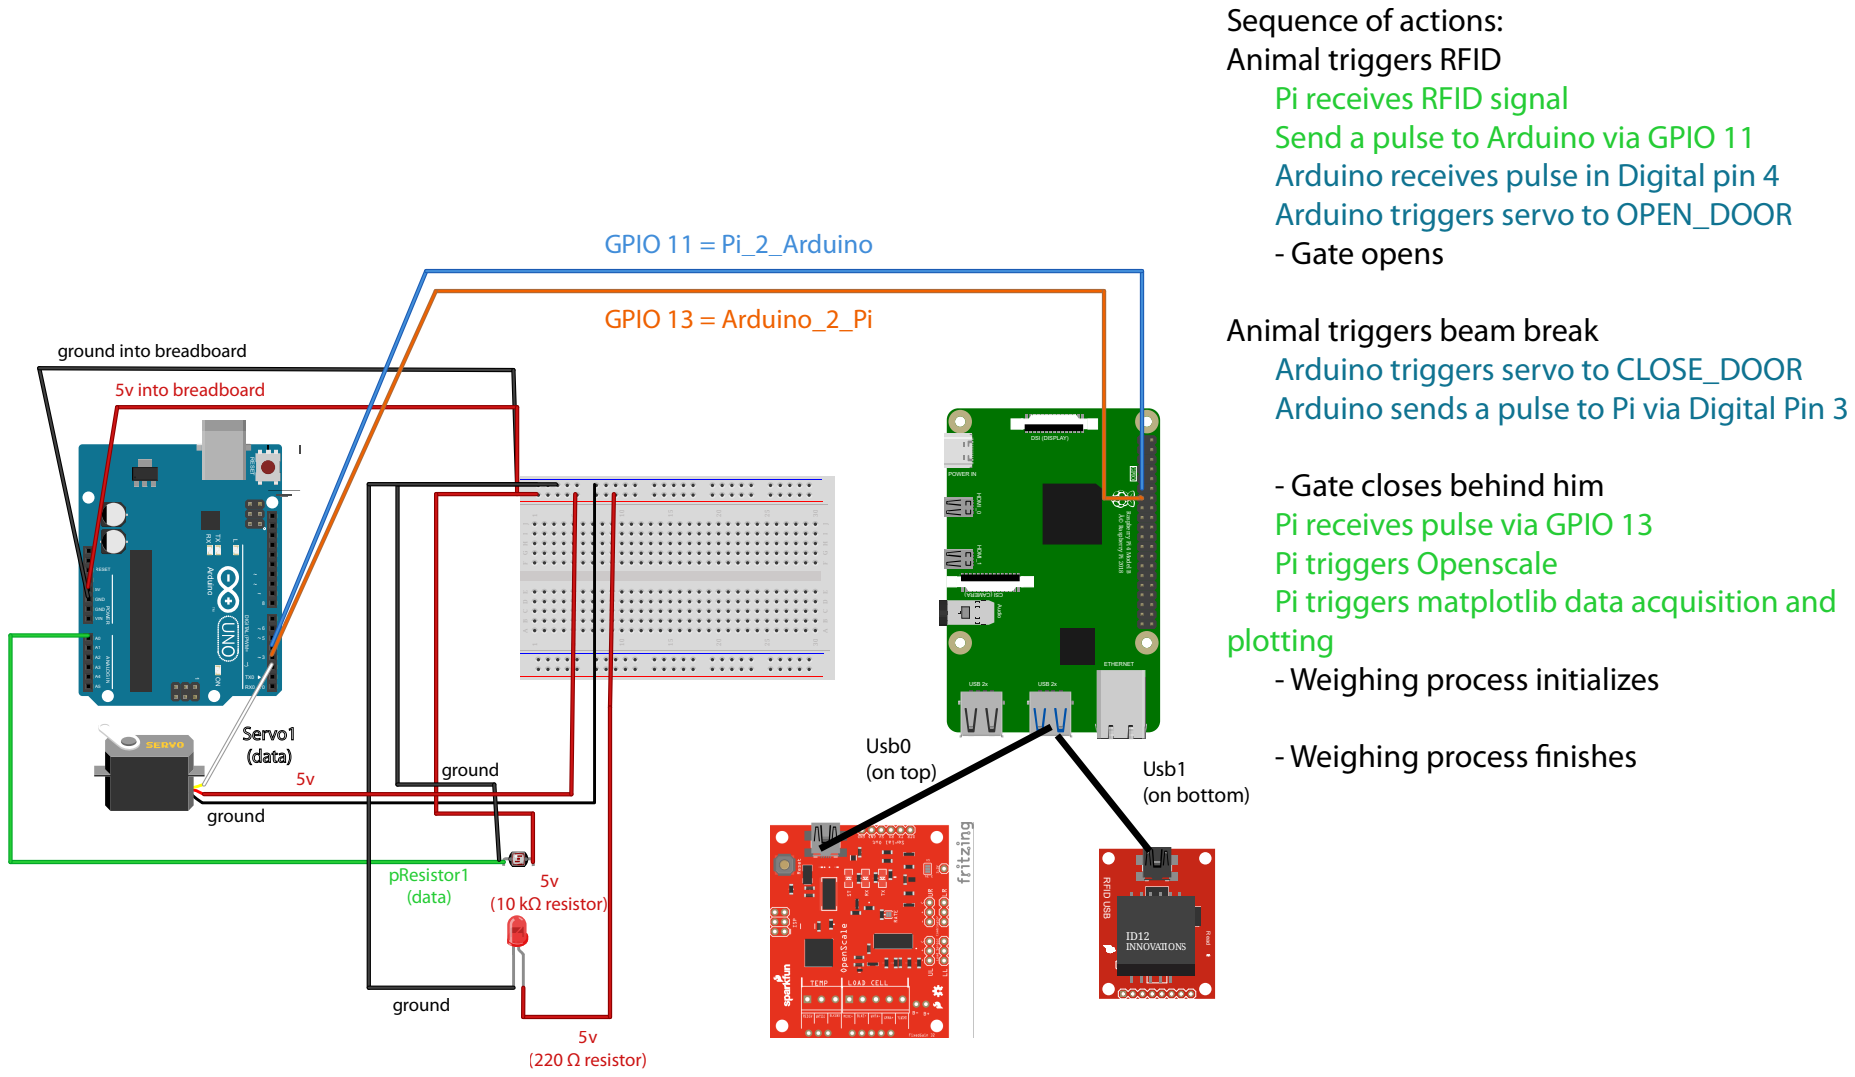
[picture p67: page 1]
ANALOG IN; RESET; VIN; GND; DIGITAL (PWM= ); Arduino TM; POWER; RX0RESET; Â© Raspberry Pi 2018; POWER IN; HDMI_1 HDMI_0; Audio; DSI (DISPLAY); ETHERNET; USB 2x; GPIO; RFID USB; Read; Part; Title ID12 INNOVATIONS; Usb0; (on top); Usb1; (on bottom); GPIO 11 = Pi_2_Arduino; GPIO 13 = Arduino_2_Pi; 5v (220 Ω resistor); 5v (10 kΩ resistor); ground; pResistor1 (data)

Sequence of actions:
Animal triggers RFID
Pi receives RFID signal
Send a pulse to Arduino via GPIO 11
Arduino receives pulse in Digital pin 4
Arduino triggers servo to OPEN_DOOR
- Gate opens

Animal triggers beam break
Arduino triggers servo to CLOSE_DOOR
Arduino sends a pulse to Pi via Digital Pin 3

ground into breadboard
5v into breadboard

- Gate closes behind him
Pi receives pulse via GPIO 13
Pi triggers Openscale
Pi triggers matplotlib data acquisition and

Raspberry Pi 4 Model B

plotting
- Weighing process initializes

- Weighing process nishes
