Borgesvpm/Amaze/OpenScale/Extra resources/SparkFun_openScale_schematic.pdf

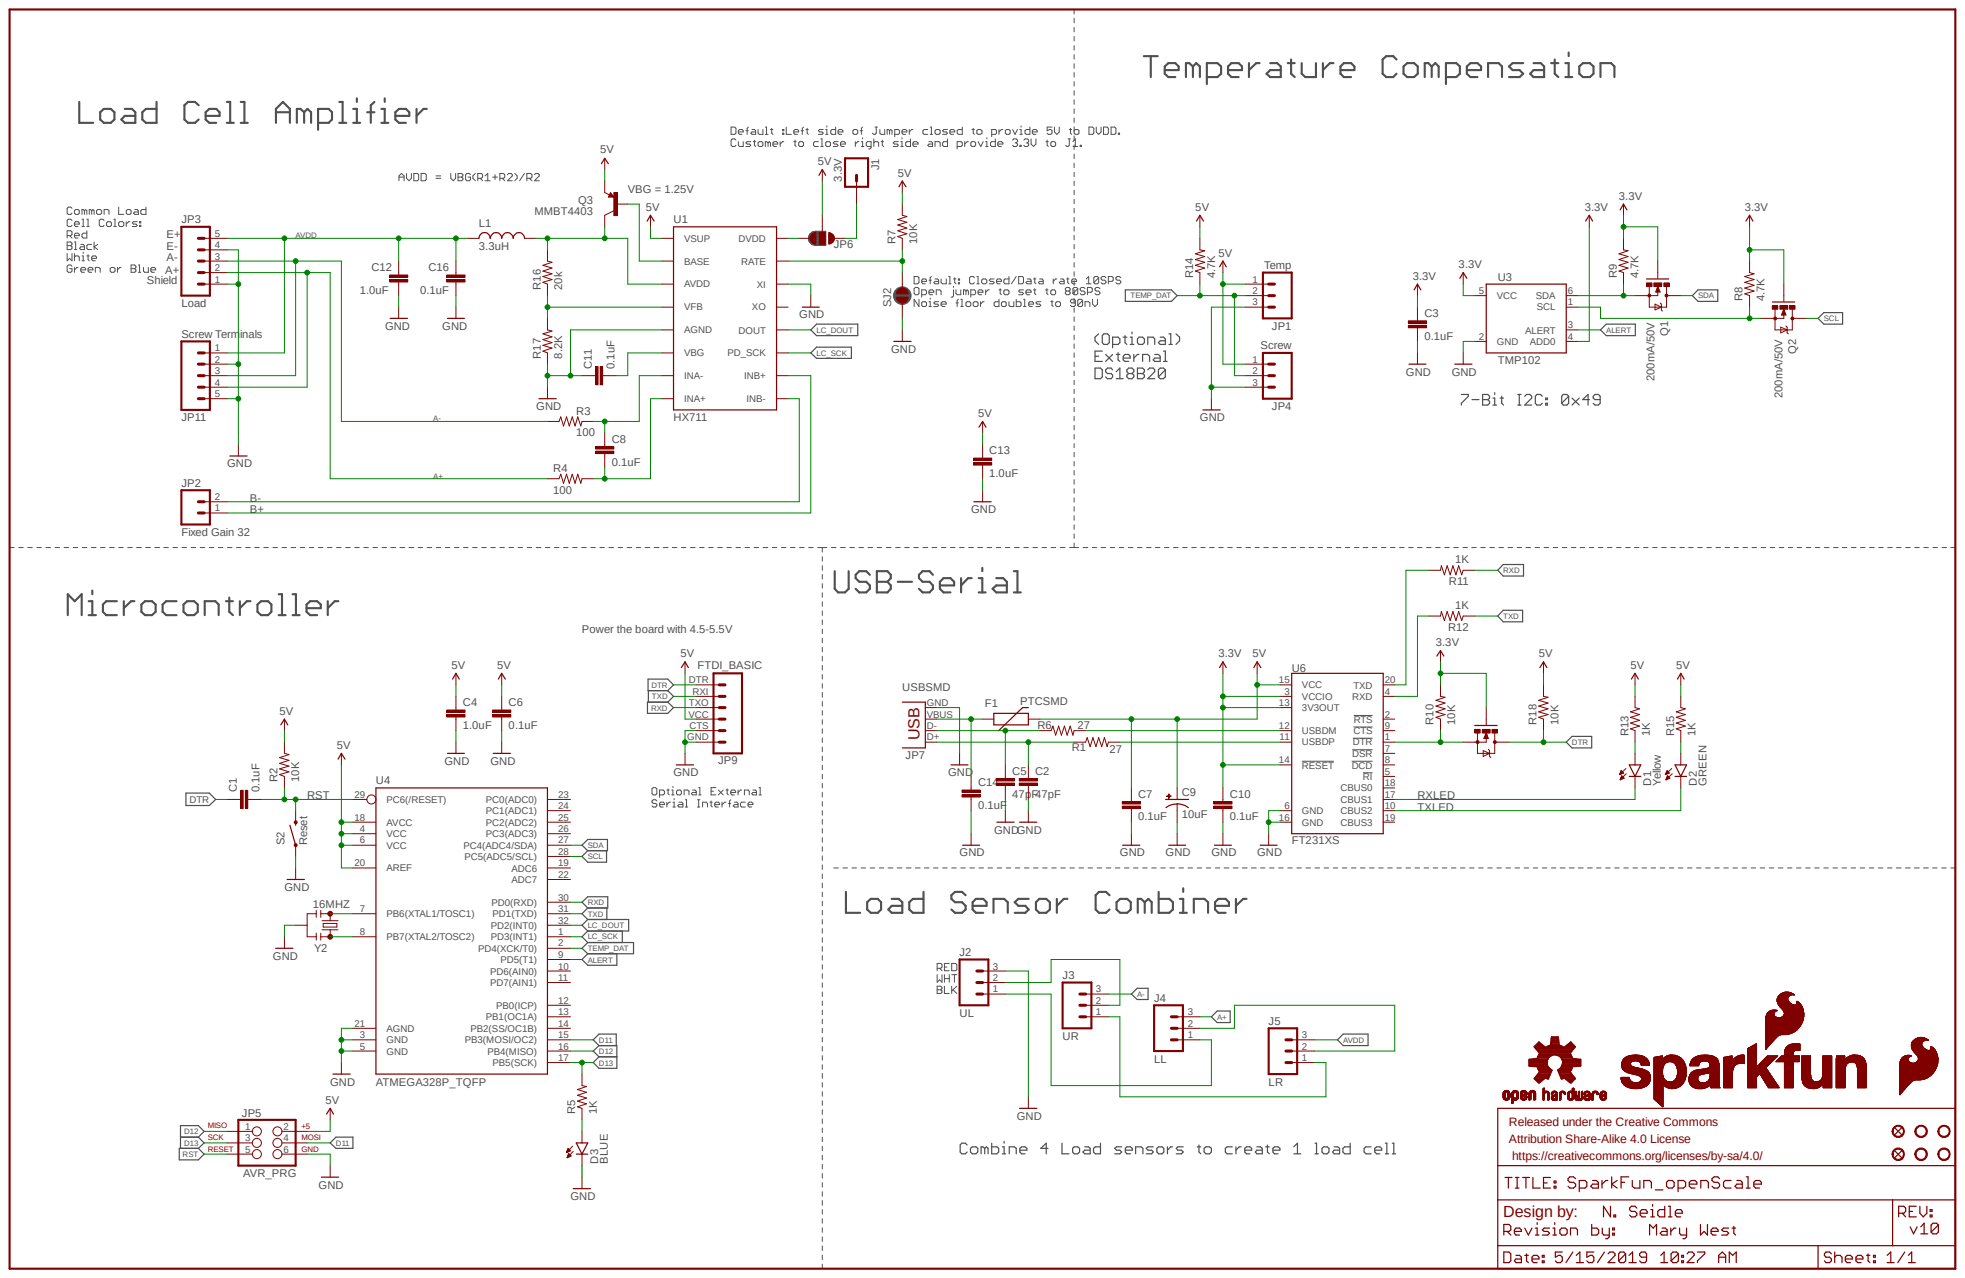
[picture p68: page 1]

Power the board with 4.5-5.5V

Released under the Creative Commons
Attribution Share-Alike 4.0 License
https://creativecommons.org/licenses/by-sa/4.0/
