Borgesvpm/Amaze/(list of files, drawings)

Other design files:
OpenScale/OpenScale-master/Documentation/Untitled Sketch.fzz
Schematic_Amaze/Schematic_Amaze.fzz
