Borgesvpm/Amaze/OpenScale/OpenScale-master/hardware/SparkFun_openScale.brd

## EAGLE design OpenScale/OpenScale-master/hardware/SparkFun_openScale.brd (2020-11-23)

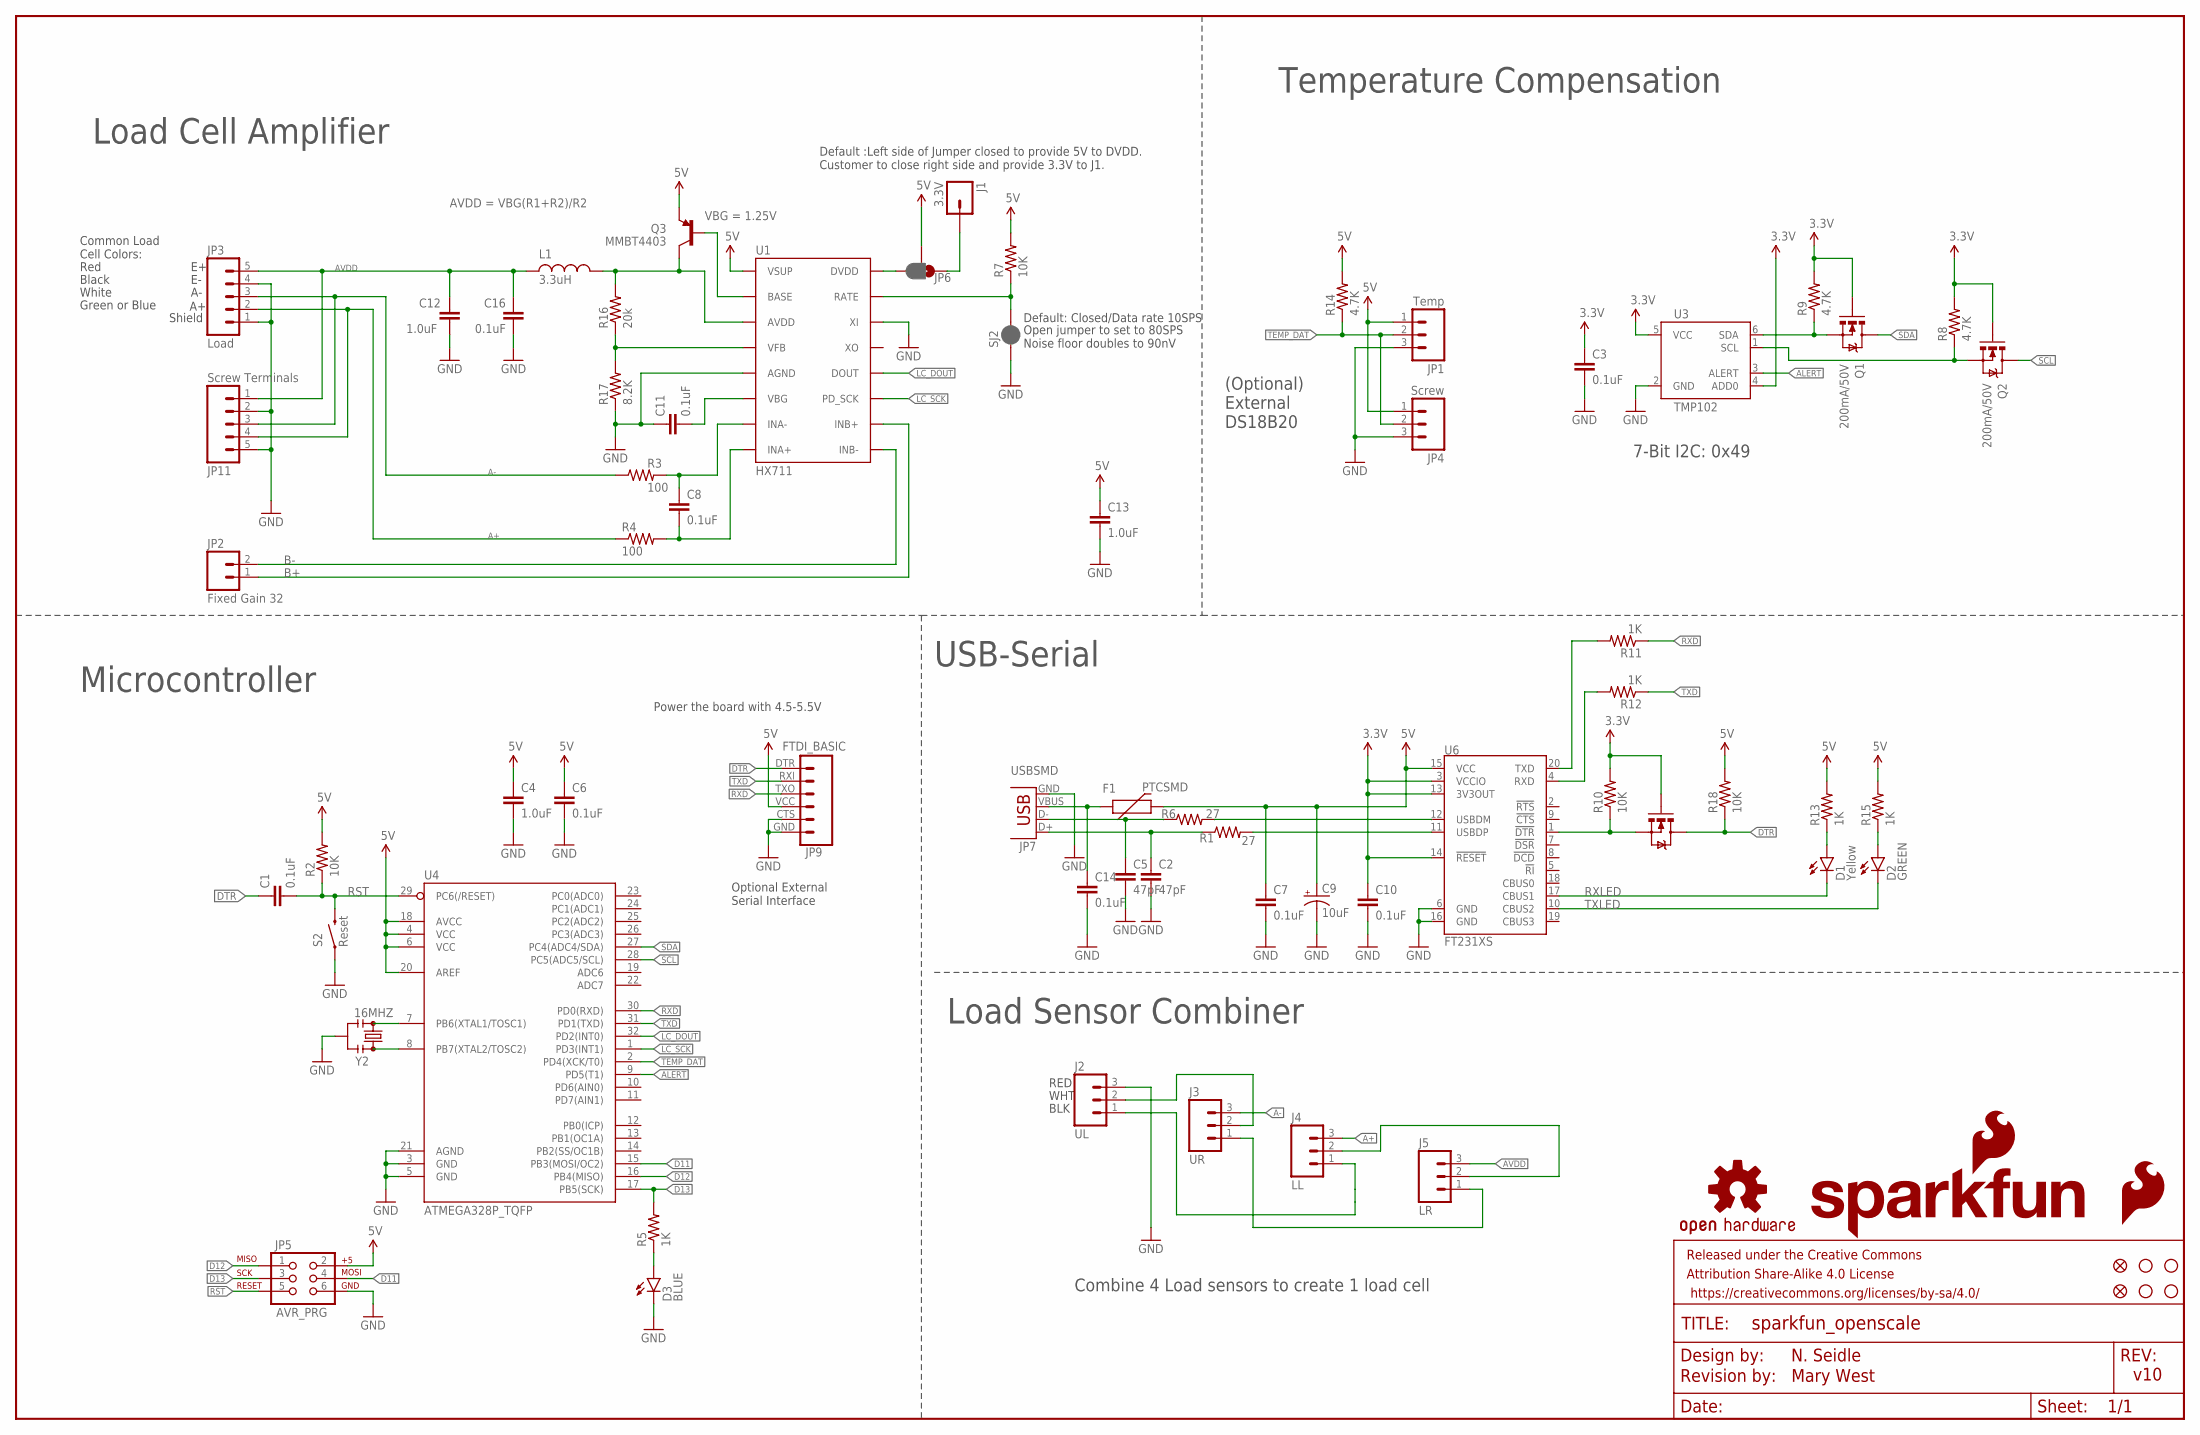
[picture p69: schematic SparkFun_openScale.sch]

Parts:
C1, C3, C6, C7, C8, C10, C11, C14, C16: 0.1uF; 0603-CAP
C2, C5: 47pF; 0603-CAP
C4, C12, C13: 1.0uF; 0603-CAP
C9: 10uF; EIA3216
D1: Yellow; LED-1206
D2: GREEN; LED-1206
D3: BLUE; LED-1206
F1: PTCSMD; PTC-1206
FID1, FID2: FIDUCIALUFIDUCIAL; MICRO-FIDUCIAL
FRAME1: FRAME-LEDGER; CREATIVE_COMMONS
J1: 3.3V; 1X01
J2: UL; 1X03
J3: UR; 1X03
J4: LL; 1X03
J5: LR; 1X03
JP1: Temp; 1X03_NO_SILK
JP2: Fixed Gain 32; 1X02
JP3: Load; 1X05_NO_SILK
JP4: Screw; SCREWTERMINAL-3.5MM-3_LOCK.007S
JP5: AVR_PRG; 2X3
JP6: JUMPER-PAD-3-2OF3_NC_BY_PASTE; PAD-JUMPER-3-2OF3_NC_BY_PASTE_YES_SILK_FULL_BOX
JP7: USBSMD; USB-MINIB
JP9: FTDI_BASIC
JP11: Screw Terminals; SCREWTERMINAL-3.5MM-5
L1: 3.3uH; 0805
LOGO2: OSHW-LOGOS; OSHW-LOGO-S
LOGO3: SFE_LOGO_FLAME.1_INCH; SFE_LOGO_FLAME_.1
LOGO4: SFE_LOGO_NAME_FLAME.1_INCH; SFE_LOGO_NAME_FLAME_.1
Q1, Q2: 200mA/50V; SOT23-3
Q3: MMBT4403; SOT23-3
Q4: MOSFET-NCHANNEL2N7002PW; SOT323
R1, R6: 27; 0603
R2, R7, R10, R18: 10K; 0603-RES
R3, R4: 100; 0603-RES
R5, R11, R12, R13, R15: 1K; 0603-RES
R8, R9, R14: 4.7K; 0603-RES
R16: 20k; 0603-RES
R17: 8.2K; 0603-RES
S2: Reset; TACTILE-SWITCH-SMD
SJ2: JUMPER-PAD-2-NC_BY_PASTE; PAD-JUMPER-2-NC_BY_PASTE_YES_SILK
STANDOFF1, STANDOFF2, STANDOFF3, STANDOFF4: STAND-OFF
U1: HX711; SO16
U3: TMP102; SOT563
U4: ATMEGA328P_TQFP; TQFP32-08
U6: FT231XS; SSOP20_L
Y2: 16MHZ; RESONATOR-SMD

Connections:
2: J4.2, J5.2
3.3V: C3.1, C10.1, Q1.1 (G), Q2.1 (G), Q4.1 (G), R8.2, R9.2, R10.2, U3.4 (ADD0), U3.5 (VCC), U6.3 (VCCIO), U6.13 (3V3OUT), U6.14 (!RESET)
5V: C4.1, C6.1, C7.1, C9.A (+), C13.1, F1.2, JP1.1, JP4.1, JP5.2, JP6.2, JP9.VCC (4), Q3.2 (E), R2.2, R7.2, R13.2, R14.2, R15.2, R18.2, U1.1 (VSUP), U4.4 (VCC), U4.6 (VCC), U4.18 (AVCC), U4.20 (AREF), U6.15 (VCC)
A+: J4.3, JP3.2, JP11.4, R4.1
A-: J3.3, JP3.3, JP11.3, R3.1
ALERT: U3.3 (ALERT), U4.9 (PD5(T1))
AVDD: C12.2, C16.1, J5.3, JP3.5, JP11.1, L1.1
B+: JP2.1, U1.10 (INB+)
B-: JP2.2, U1.9 (INB-)
D11: JP5.4, U4.15 (PB3(MOSI/OC2))
D12: JP5.1, U4.16 (PB4(MISO))
D13: JP5.3, R5.2, U4.17 (PB5(SCK))
DTR: C1.1, JP9.DTR (1), Q4.3 (D), R18.1
GND: C2.2, C3.2, C4.2, C5.2, C6.2, C7.2, C9.C (-), C10.2, C11.1, C12.1, C13.2, C14.2, C16.2, D3.C, J2.3, JP1.3, JP3.1, JP3.4, JP4.3, JP5.6, JP7.GND, JP9.CTS (5), JP9.GND (6), JP11.2, JP11.5, R17.1, S2.1, SJ2.1, U1.5 (AGND), U1.14 (XI), U3.2 (GND), U4.3 (GND), U4.5 (GND), U4.21 (AGND), U6.6 (GND), U6.16 (GND), Y2.2
LC_DOUT: U1.12 (DOUT), U4.32 (PD2(INT0))
LC_SCK: U1.11 (PD_SCK), U4.1 (PD3(INT1))
LV_SCL: Q2.2 (S), R8.1, U3.1 (SCL)
LV_SDA: Q1.2 (S), R9.1, U3.6 (SDA)
unnamed: U4.7 (PB6(XTAL1/TOSC1)), Y2.1
unnamed: D3.A, R5.1
unnamed: U4.8 (PB7(XTAL2/TOSC2)), Y2.3
unnamed: C5.1, JP7.D-, R6.1
unnamed: D1.A, R13.1
unnamed: D2.A, R15.1
unnamed: C2.1, JP7.D+, R1.1
unnamed: R6.2, U6.12 (USBDM)
unnamed: R7.1, SJ2.2, U1.15 (RATE)
unnamed: C8.1, R3.2, U1.7 (INA-)
unnamed: C8.2, R4.2, U1.8 (INA+)
unnamed: C14.1, F1.1, JP7.VBUS
unnamed: R1.2, U6.11 (USBDP)
unnamed: R12.2, U6.4 (RXD)
unnamed: JP6.3, U1.16 (DVDD)
unnamed: R11.2, U6.20 (TXD)
unnamed: Q3.1 (B), U1.2 (BASE)
unnamed: R16.1, R17.2, U1.4 (VFB)
unnamed: J1.1, JP6.1
unnamed: J2.2, J3.2
unnamed: C11.2, U1.6 (VBG)
unnamed: J2.1, J4.1
unnamed: J3.1, J5.1
unnamed: Q4.2 (S), R10.1, U6.1 (!DTR)
RIPUP@: L1.2, Q3.3 (C), R16.2, U1.3 (AVDD)
RST: C1.2, JP5.5, R2.1, S2.3 (2), U4.29 (PC6(/RESET))
RXD: JP9.TXO (3), R11.1, U4.30 (PD0(RXD))
RXLED: D1.C, U6.17 (CBUS1)
SCL: Q2.3 (D), U4.28 (PC5(ADC5/SCL))
SDA: Q1.3 (D), U4.27 (PC4(ADC4/SDA))
TEMP_DAT: JP1.2, JP4.2, R14.1, U4.2 (PD4(XCK/T0))
TXD: JP9.RXI (2), R12.1, U4.31 (PD1(TXD))
TXLED: D2.C, U6.10 (CBUS2)

Notes on the sheet:
Microcontroller
USB-Serial
Default: Closed/Data rate 10SPS
Open jumper to set to 80SPS Noise floor doubles to 90nV
Red
Black
White
Green or Blue
Common Load Cell Colors:
Temperature Compensation
(Optional) External DS18B20
Load Cell Amplifier
7-Bit I2C: 0x49
Shield
Optional External Serial Interface
VBG = 1.25V
AVDD = VBG(R1+R2)/R2
v10
N. Seidle
Power the board with 4.5-5.5V
RED
WHT
BLK
Combine 4 Load sensors to create 1 load cell
Load Sensor Combiner
Default :Left side of Jumper closed to provide 5V to DVDD. Customer to close right side and provide 3.3V to J1.
Revision by: Mary West

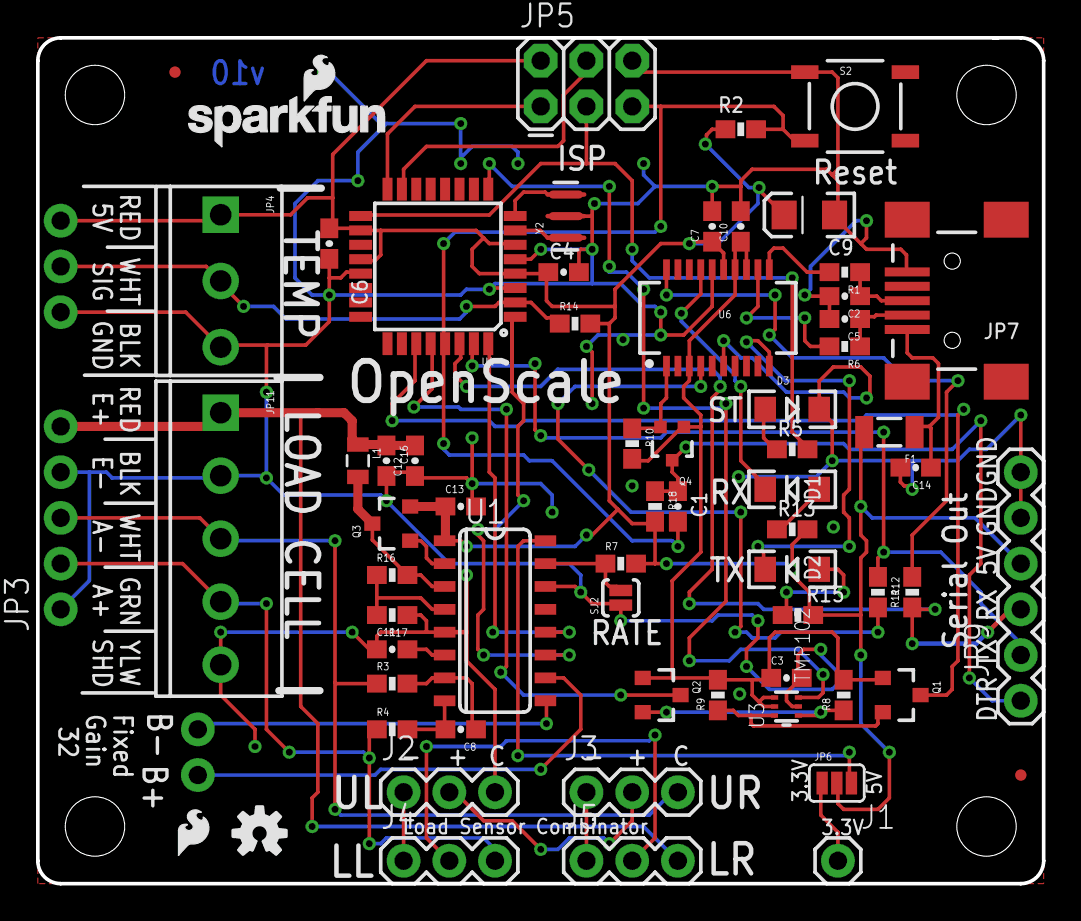
[picture p70: board SparkFun_openScale.brd from above]

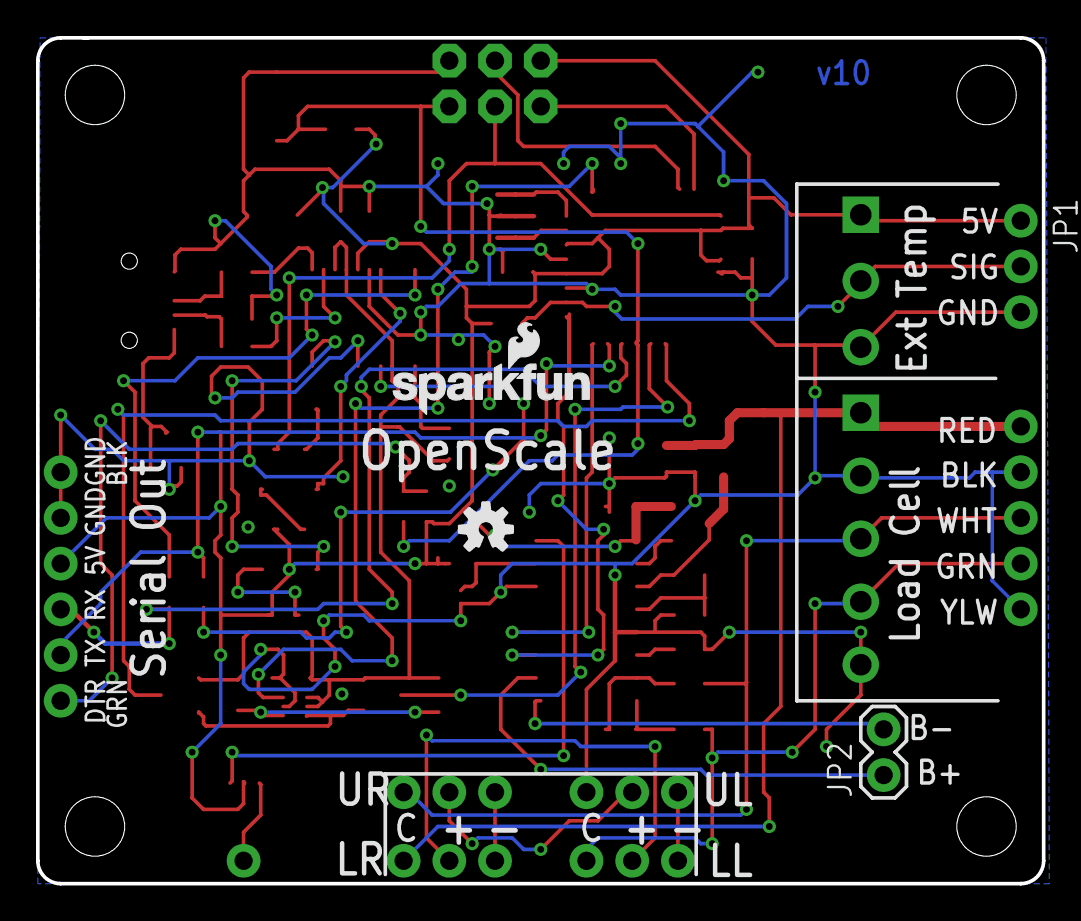
[picture p71: board SparkFun_openScale.brd from below]

Board: 2 copper layers, 55.9 x 47.0 mm, 75 parts (4 on the bottom side), 51 nets.

Other parts of the board:
LOGO1: SFE_LOGO_NAME_FLAME.1_INCH; SFE_LOGO_NAME_FLAME_.1
LOGO5: OSHW-LOGOS; OSHW-LOGO-S
