Borgesvpm/Amaze/OpenScale/OpenScale-master/Production/SparkFun_OpenScale_Panel_v10.brd

## EAGLE design OpenScale/OpenScale-master/Production/SparkFun_OpenScale_Panel_v10.brd (2020-11-23)

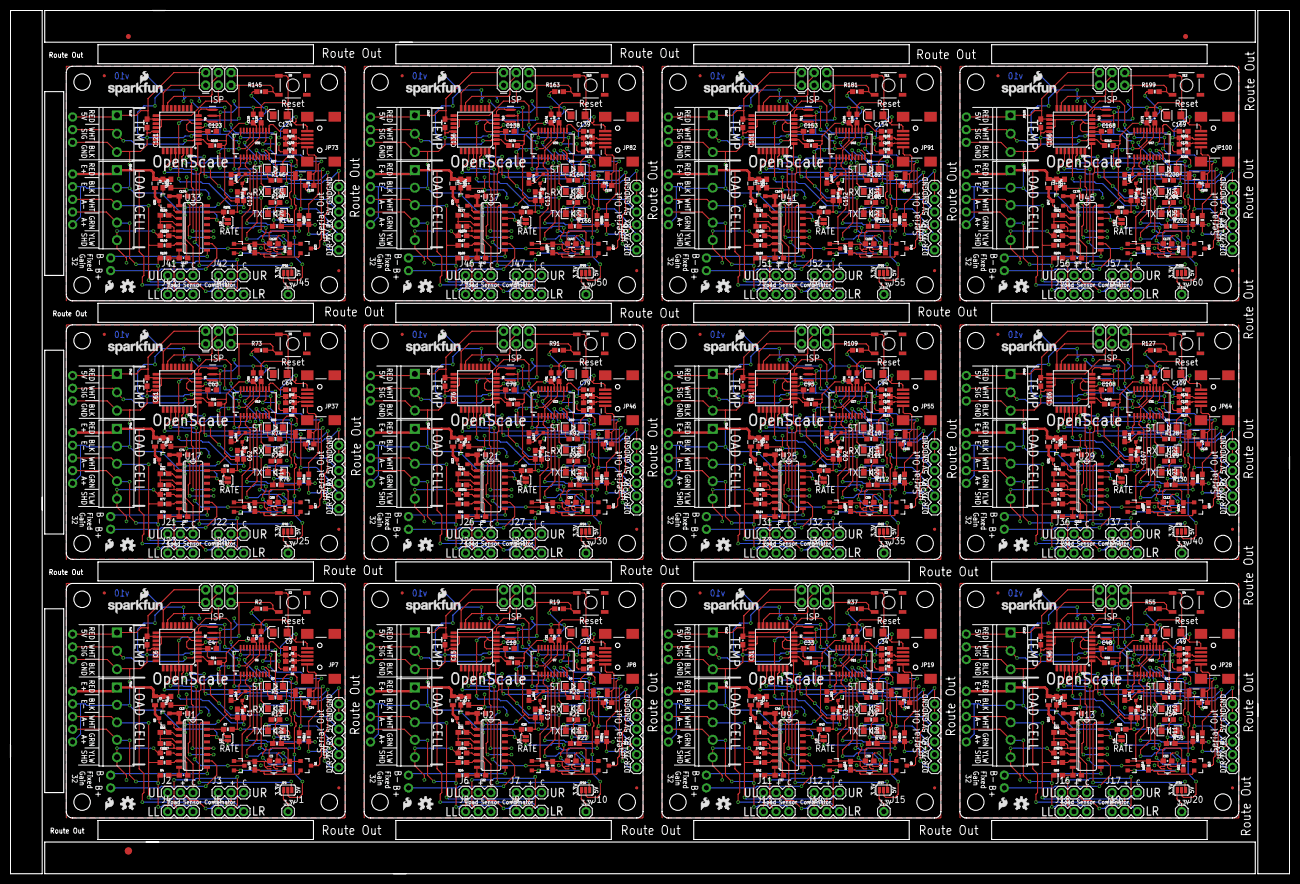
[picture p72: board SparkFun_OpenScale_Panel_v10.brd from above]

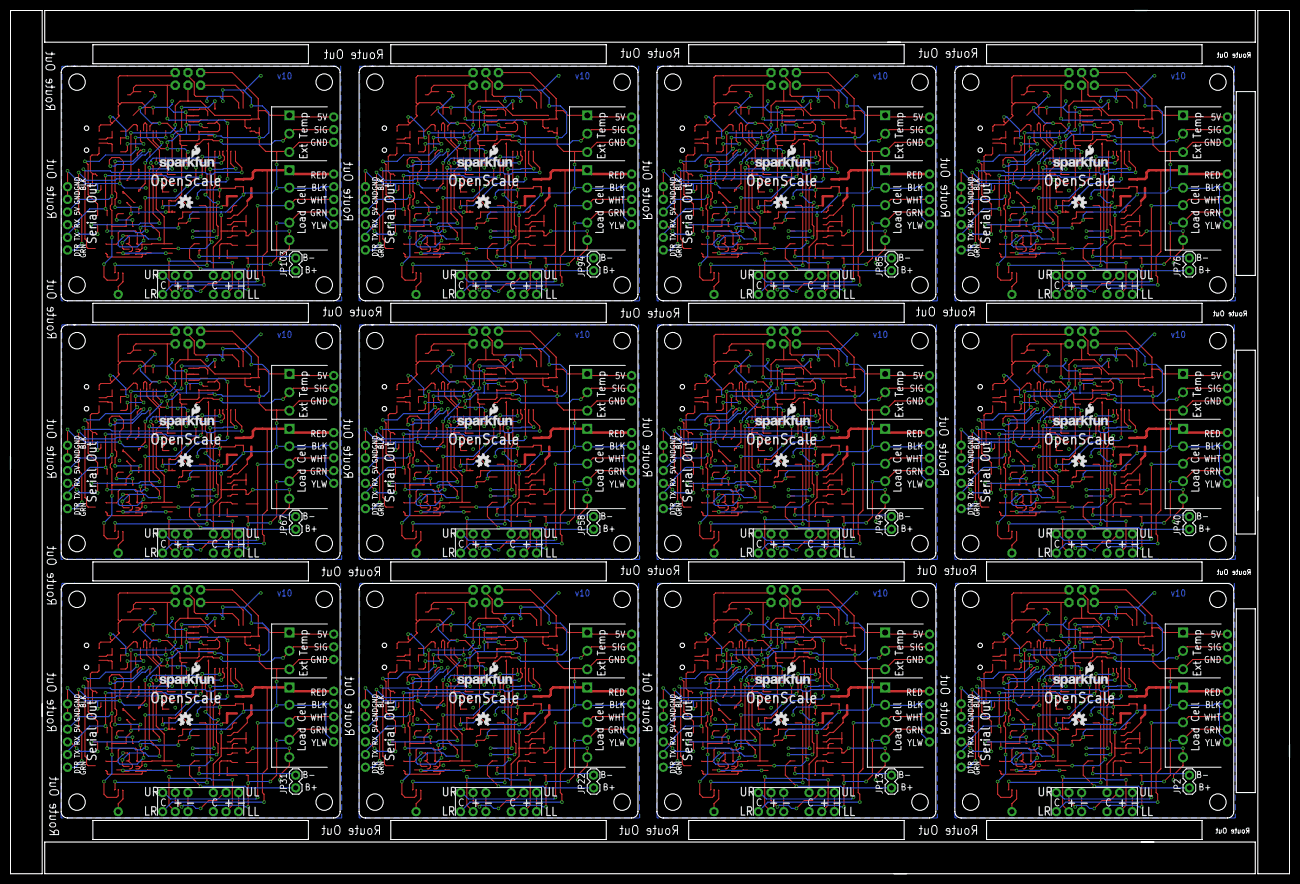
[picture p73: board SparkFun_OpenScale_Panel_v10.brd from below]

Board: 2 copper layers, 256.3 x 173.0 mm, 891 parts (48 on the bottom side), 612 nets.

Parts:
C1, C3, C6, C7, C8, C10, C11, C14, C15, C16, C17, C20, C21, C22, C23, C24, C27, C30, C31, C32, C35, C36, C37, C38, C39, C42, C45, C46, C47, C50, C51, C52, C53, C54, C57, C60, C61, C62, C65, C66, C67, C68, C69, C72, C75, C76, C77, C80, C81, C82, C83, C84, C87, C90, C91, C92, C95, C96, C97, C98, C99, C102, C105, C106, C107, C110, C111, C112, C113, C114, C117, C120, C121, C122, C125, C126, C127, C128, C129, C132, C135, C136, C137, C140, C141, C142, C143, C144, C147, C150, C151, C152, C155, C156, C157, C158, C159, C162, C165, C166, C167, C170, C171, C172, C173, C174, C177, C180: 0.1uF; 0603-CAP
C2, C5, C25, C26, C40, C41, C55, C56, C70, C71, C85, C86, C100, C101, C115, C116, C130, C131, C145, C146, C160, C161, C175, C176: 47pF; 0603-CAP
C4, C12, C13, C18, C28, C29, C33, C43, C44, C48, C58, C59, C63, C73, C74, C78, C88, C89, C93, C103, C104, C108, C118, C119, C123, C133, C134, C138, C148, C149, C153, C163, C164, C168, C178, C179: 1.0uF; 0603-CAP
C9, C19, C34, C49, C64, C79, C94, C109, C124, C139, C154, C169: 10uF; EIA3216
D1, D4, D7, D10, D13, D16, D19, D22, D25, D28, D31, D34: Yellow; LED-1206
D2, D5, D8, D11, D14, D17, D20, D23, D26, D29, D32, D35: GREEN; LED-1206
D3, D6, D9, D12, D15, D18, D21, D24, D27, D30, D33, D36: BLUE; LED-1206
E$1: FIDUCIAL-1.5X3
E$7, E$8: FIDUCIAL-1X2
F1, F2, F3, F4, F5, F6, F7, F8, F9, F10, F11, F12: PTCSMD; PTC-1206
FID1, FID2, FID3, FID4, FID5, FID6, FID7, FID8, FID9, FID10, FID11, FID12, FID13, FID14, FID15, FID16, FID17, FID18, FID19, FID20, FID21, FID22, FID23, FID24: FIDUCIALUFIDUCIAL; MICRO-FIDUCIAL
J1, J10, J15, J20, J25, J30, J35, J40, J45, J50, J55, J60: 3.3V; 1X01
J2, J6, J11, J16, J21, J26, J31, J36, J41, J46, J51, J56: UL; 1X03
J3, J7, J12, J17, J22, J27, J32, J37, J42, J47, J52, J57: UR; 1X03
J4, J8, J13, J18, J23, J28, J33, J38, J43, J48, J53, J58: LL; 1X03
J5, J9, J14, J19, J24, J29, J34, J39, J44, J49, J54, J59: LR; 1X03
JP1, JP12, JP21, JP30, JP39, JP48, JP57, JP66, JP75, JP84, JP93, JP102: Temp; 1X03_NO_SILK
JP2, JP13, JP22, JP31, JP40, JP49, JP58, JP67, JP76, JP85, JP94, JP103: Fixed Gain 32; 1X02
JP3, JP16, JP25, JP34, JP43, JP52, JP61, JP70, JP79, JP88, JP97, JP106: Load; 1X05_NO_SILK
JP4, JP15, JP24, JP33, JP42, JP51, JP60, JP69, JP78, JP87, JP96, JP105: Screw; SCREWTERMINAL-3.5MM-3_LOCK.007S
JP5, JP10, JP20, JP29, JP38, JP47, JP56, JP65, JP74, JP83, JP92, JP101: AVR_PRG; 2X3
JP6, JP18, JP27, JP36, JP45, JP54, JP63, JP72, JP81, JP90, JP99, JP108: JUMPER-PAD-3-2OF3_NC_BY_PASTE; PAD-JUMPER-3-2OF3_NC_BY_PASTE_YES_SILK_FULL_BOX
JP7, JP8, JP19, JP28, JP37, JP46, JP55, JP64, JP73, JP82, JP91, JP100: USBSMD; USB-MINIB
JP9, JP14, JP23, JP32, JP41, JP50, JP59, JP68, JP77, JP86, JP95, JP104: FTDI_BASIC
JP11, JP17, JP26, JP35, JP44, JP53, JP62, JP71, JP80, JP89, JP98, JP107: Screw Terminals; SCREWTERMINAL-3.5MM-5
L1, L2, L3, L4, L5, L6, L7, L8, L9, L10, L11, L12: 3.3uH; 0805
LOGO1, LOGO4, LOGO7, LOGO9, LOGO12, LOGO14, LOGO17, LOGO19, LOGO22, LOGO24, LOGO27, LOGO29, LOGO32, LOGO34, LOGO37, LOGO39, LOGO42, LOGO44, LOGO47, LOGO49, LOGO52, LOGO54, LOGO57, LOGO59: SFE_LOGO_NAME_FLAME.1_INCH; SFE_LOGO_NAME_FLAME_.1
LOGO2, LOGO5, LOGO6, LOGO10, LOGO11, LOGO15, LOGO16, LOGO20, LOGO21, LOGO25, LOGO26, LOGO30, LOGO31, LOGO35, LOGO36, LOGO40, LOGO41, LOGO45, LOGO46, LOGO50, LOGO51, LOGO55, LOGO56, LOGO60: OSHW-LOGOS; OSHW-LOGO-S
LOGO3, LOGO8, LOGO13, LOGO18, LOGO23, LOGO28, LOGO33, LOGO38, LOGO43, LOGO48, LOGO53, LOGO58: SFE_LOGO_FLAME.1_INCH; SFE_LOGO_FLAME_.1
Q1, Q2, Q5, Q6, Q9, Q10, Q13, Q14, Q17, Q18, Q21, Q22, Q25, Q26, Q29, Q30, Q33, Q34, Q37, Q38, Q41, Q42, Q45, Q46: 200mA/50V; SOT23-3
Q3, Q7, Q11, Q15, Q19, Q23, Q27, Q31, Q35, Q39, Q43, Q47: MMBT4403; SOT23-3
Q4, Q8, Q12, Q16, Q20, Q24, Q28, Q32, Q36, Q40, Q44, Q48: MOSFET-NCHANNEL2N7002PW; SOT323
R1, R6, R28, R29, R46, R47, R64, R65, R82, R83, R100, R101, R118, R119, R136, R137, R154, R155, R172, R173, R190, R191, R208, R209: 27; 0603
R2, R7, R10, R18, R19, R25, R35, R36, R37, R43, R53, R54, R55, R61, R71, R72, R73, R79, R89, R90, R91, R97, R107, R108, R109, R115, R125, R126, R127, R133, R143, R144, R145, R151, R161, R162, R163, R169, R179, R180, R181, R187, R197, R198, R199, R205, R215, R216: 10K; 0603-RES
R3, R4, R23, R24, R41, R42, R59, R60, R77, R78, R95, R96, R113, R114, R131, R132, R149, R150, R167, R168, R185, R186, R203, R204: 100; 0603-RES
R5, R11, R12, R13, R15, R20, R21, R22, R30, R31, R38, R39, R40, R48, R49, R56, R57, R58, R66, R67, R74, R75, R76, R84, R85, R92, R93, R94, R102, R103, R110, R111, R112, R120, R121, R128, R129, R130, R138, R139, R146, R147, R148, R156, R157, R164, R165, R166, R174, R175, R182, R183, R184, R192, R193, R200, R201, R202, R210, R211: 1K; 0603-RES
R8, R9, R14, R26, R27, R32, R44, R45, R50, R62, R63, R68, R80, R81, R86, R98, R99, R104, R116, R117, R122, R134, R135, R140, R152, R153, R158, R170, R171, R176, R188, R189, R194, R206, R207, R212: 4.7K; 0603-RES
R16, R33, R51, R69, R87, R105, R123, R141, R159, R177, R195, R213: 20k; 0603-RES
R17, R34, R52, R70, R88, R106, R124, R142, R160, R178, R196, R214: 8.2K; 0603-RES
S1, S2, S3, S4, S5, S6, S7, S8, S9, S10, S11, S12: Reset; TACTILE-SWITCH-SMD
SJ1, SJ2, SJ3, SJ4, SJ5, SJ6, SJ7, SJ8, SJ9, SJ10, SJ11, SJ12: JUMPER-PAD-2-NC_BY_PASTE; PAD-JUMPER-2-NC_BY_PASTE_YES_SILK
STANDOFF1, STANDOFF2, STANDOFF3, STANDOFF4, STANDOFF5, STANDOFF6, STANDOFF7, STANDOFF8, STANDOFF9, STANDOFF10, STANDOFF11, STANDOFF12, STANDOFF13, STANDOFF14, STANDOFF15, STANDOFF16, STANDOFF17, STANDOFF18, STANDOFF19, STANDOFF20, STANDOFF21, STANDOFF22, STANDOFF23, STANDOFF24, STANDOFF25, STANDOFF26, STANDOFF27, STANDOFF28, STANDOFF29, STANDOFF30, STANDOFF31, STANDOFF32, STANDOFF33, STANDOFF34, STANDOFF35, STANDOFF36, STANDOFF37, STANDOFF38, STANDOFF39, STANDOFF40, STANDOFF41, STANDOFF42, STANDOFF43, STANDOFF44, STANDOFF45, STANDOFF46, STANDOFF47, STANDOFF48: STAND-OFF
U1, U2, U9, U13, U17, U21, U25, U29, U33, U37, U41, U45: HX711; SO16
U3, U5, U10, U14, U18, U22, U26, U30, U34, U38, U42, U46: TMP102; SOT563
U4, U8, U12, U16, U20, U24, U28, U32, U36, U40, U44, U48: ATMEGA328P_TQFP; TQFP32-08
U6, U7, U11, U15, U19, U23, U27, U31, U35, U39, U43, U47: FT231XS; SSOP20_L
Y1, Y2, Y3, Y4, Y5, Y6, Y7, Y8, Y9, Y10, Y11, Y12: 16MHZ; RESONATOR-SMD

Connections:
1: J8.2, J9.2
2: J4.2, J5.2
3: J13.2, J14.2
3.3V: C3.1, C10.1, Q1.1, Q2.1, Q4.1, R8.2, R9.2, R10.2, U3.4, U3.5, U6.3, U6.13, U6.14
3.3V1: C20.1, C23.1, Q5.1, Q6.1, Q8.1, R26.2, R27.2, R35.2, U5.4, U5.5, U7.3, U7.13, U7.14
3.3V2: C35.1, C38.1, Q9.1, Q10.1, Q12.1, R44.2, R45.2, R53.2, U10.4, U10.5, U11.3, U11.13, U11.14
3.3V3: C50.1, C53.1, Q13.1, Q14.1, Q16.1, R62.2, R63.2, R71.2, U14.4, U14.5, U15.3, U15.13, U15.14
3.3V4: C65.1, C68.1, Q17.1, Q18.1, Q20.1, R80.2, R81.2, R89.2, U18.4, U18.5, U19.3, U19.13, U19.14
3.3V5: C80.1, C83.1, Q21.1, Q22.1, Q24.1, R98.2, R99.2, R107.2, U22.4, U22.5, U23.3, U23.13, U23.14
3.3V6: C95.1, C98.1, Q25.1, Q26.1, Q28.1, R116.2, R117.2, R125.2, U26.4, U26.5, U27.3, U27.13, U27.14
3.3V7: C110.1, C113.1, Q29.1, Q30.1, Q32.1, R134.2, R135.2, R143.2, U30.4, U30.5, U31.3, U31.13, U31.14
3.3V8: C125.1, C128.1, Q33.1, Q34.1, Q36.1, R152.2, R153.2, R161.2, U34.4, U34.5, U35.3, U35.13, U35.14
3.3V9: C140.1, C143.1, Q37.1, Q38.1, Q40.1, R170.2, R171.2, R179.2, U38.4, U38.5, U39.3, U39.13, U39.14
3.3V10: C155.1, C158.1, Q41.1, Q42.1, Q44.1, R188.2, R189.2, R197.2, U42.4, U42.5, U43.3, U43.13, U43.14
3.3V11: C170.1, C173.1, Q45.1, Q46.1, Q48.1, R206.2, R207.2, R215.2, U46.4, U46.5, U47.3, U47.13, U47.14
4: J18.2, J19.2
5: J23.2, J24.2
5V: C4.1, C6.1, C7.1, C9.A, C13.1, F1.2, JP1.1, JP4.1, JP5.2, JP6.2, JP9.VCC, Q3.2, R2.2, R7.2, R13.2, R14.2, R15.2, R18.2, U1.1, U4.4, U4.6, U4.18, U4.20, U6.15
5V1: C15.1, C18.1, C19.A, C21.1, C29.1, F2.2, JP10.2, JP12.1, JP14.VCC, JP15.1, JP18.2, Q7.2, R19.2, R21.2, R22.2, R25.2, R32.2, R36.2, U2.1, U7.15, U8.4, U8.6, U8.18, U8.20
5V2: C31.1, C33.1, C34.A, C36.1, C44.1, F3.2, JP20.2, JP21.1, JP23.VCC, JP24.1, JP27.2, Q11.2, R37.2, R39.2, R40.2, R43.2, R50.2, R54.2, U9.1, U11.15, U12.4, U12.6, U12.18, U12.20
5V3: C46.1, C48.1, C49.A, C51.1, C59.1, F4.2, JP29.2, JP30.1, JP32.VCC, JP33.1, JP36.2, Q15.2, R55.2, R57.2, R58.2, R61.2, R68.2, R72.2, U13.1, U15.15, U16.4, U16.6, U16.18, U16.20
5V4: C61.1, C63.1, C64.A, C66.1, C74.1, F5.2, JP38.2, JP39.1, JP41.VCC, JP42.1, JP45.2, Q19.2, R73.2, R75.2, R76.2, R79.2, R86.2, R90.2, U17.1, U19.15, U20.4, U20.6, U20.18, U20.20
5V5: C76.1, C78.1, C79.A, C81.1, C89.1, F6.2, JP47.2, JP48.1, JP50.VCC, JP51.1, JP54.2, Q23.2, R91.2, R93.2, R94.2, R97.2, R104.2, R108.2, U21.1, U23.15, U24.4, U24.6, U24.18, U24.20
5V6: C91.1, C93.1, C94.A, C96.1, C104.1, F7.2, JP56.2, JP57.1, JP59.VCC, JP60.1, JP63.2, Q27.2, R109.2, R111.2, R112.2, R115.2, R122.2, R126.2, U25.1, U27.15, U28.4, U28.6, U28.18, U28.20
5V7: C106.1, C108.1, C109.A, C111.1, C119.1, F8.2, JP65.2, JP66.1, JP68.VCC, JP69.1, JP72.2, Q31.2, R127.2, R129.2, R130.2, R133.2, R140.2, R144.2, U29.1, U31.15, U32.4, U32.6, U32.18, U32.20
5V8: C121.1, C123.1, C124.A, C126.1, C134.1, F9.2, JP74.2, JP75.1, JP77.VCC, JP78.1, JP81.2, Q35.2, R145.2, R147.2, R148.2, R151.2, R158.2, R162.2, U33.1, U35.15, U36.4, U36.6, U36.18, U36.20
5V9: C136.1, C138.1, C139.A, C141.1, C149.1, F10.2, JP83.2, JP84.1, JP86.VCC, JP87.1, JP90.2, Q39.2, R163.2, R165.2, R166.2, R169.2, R176.2, R180.2, U37.1, U39.15, U40.4, U40.6, U40.18, U40.20
5V10: C151.1, C153.1, C154.A, C156.1, C164.1, F11.2, JP92.2, JP93.1, JP95.VCC, JP96.1, JP99.2, Q43.2, R181.2, R183.2, R184.2, R187.2, R194.2, R198.2, U41.1, U43.15, U44.4, U44.6, U44.18, U44.20
5V11: C166.1, C168.1, C169.A, C171.1, C179.1, F12.2, JP101.2, JP102.1, JP104.VCC, JP105.1, JP108.2, Q47.2, R199.2, R201.2, R202.2, R205.2, R212.2, R216.2, U45.1, U47.15, U48.4, U48.6, U48.18, U48.20
6: J28.2, J29.2
7: J33.2, J34.2
8: J38.2, J39.2
9: J43.2, J44.2
10: J48.2, J49.2
11: J53.2, J54.2
12: J58.2, J59.2
A+: J4.3, JP3.2, JP11.4, R4.1
A+1: J8.3, JP16.2, JP17.4, R24.1
A+2: J13.3, JP25.2, JP26.4, R42.1
A+3: J18.3, JP34.2, JP35.4, R60.1
A+4: J23.3, JP43.2, JP44.4, R78.1
A+5: J28.3, JP52.2, JP53.4, R96.1
A+6: J33.3, JP61.2, JP62.4, R114.1
A+7: J38.3, JP70.2, JP71.4, R132.1
A+8: J43.3, JP79.2, JP80.4, R150.1
A+9: J48.3, JP88.2, JP89.4, R168.1
A+10: J53.3, JP97.2, JP98.4, R186.1
A+11: J58.3, JP106.2, JP107.4, R204.1
A-: J3.3, JP3.3, JP11.3, R3.1
A-1: J7.3, JP16.3, JP17.3, R23.1
A-2: J12.3, JP25.3, JP26.3, R41.1
A-3: J17.3, JP34.3, JP35.3, R59.1
A-4: J22.3, JP43.3, JP44.3, R77.1
A-5: J27.3, JP52.3, JP53.3, R95.1
A-6: J32.3, JP61.3, JP62.3, R113.1
A-7: J37.3, JP70.3, JP71.3, R131.1
A-8: J42.3, JP79.3, JP80.3, R149.1
A-9: J47.3, JP88.3, JP89.3, R167.1
A-10: J52.3, JP97.3, JP98.3, R185.1
A-11: J57.3, JP106.3, JP107.3, R203.1
ALERT: U3.3, U4.9
ALERT1: U5.3, U8.9
ALERT2: U10.3, U12.9
ALERT3: U14.3, U16.9
ALERT4: U18.3, U20.9
ALERT5: U22.3, U24.9
ALERT6: U26.3, U28.9
ALERT7: U30.3, U32.9
ALERT8: U34.3, U36.9
ALERT9: U38.3, U40.9
ALERT10: U42.3, U44.9
ALERT11: U46.3, U48.9
AVDD: C12.2, C16.1, J5.3, JP3.5, JP11.1, L1.1
AVDD1: C24.1, C28.2, J9.3, JP16.5, JP17.1, L2.1
AVDD2: C39.1, C43.2, J14.3, JP25.5, JP26.1, L3.1
AVDD3: C54.1, C58.2, J19.3, JP34.5, JP35.1, L4.1
AVDD4: C69.1, C73.2, J24.3, JP43.5, JP44.1, L5.1
AVDD5: C84.1, C88.2, J29.3, JP52.5, JP53.1, L6.1
AVDD6: C99.1, C103.2, J34.3, JP61.5, JP62.1, L7.1
AVDD7: C114.1, C118.2, J39.3, JP70.5, JP71.1, L8.1
AVDD8: C129.1, C133.2, J44.3, JP79.5, JP80.1, L9.1
AVDD9: C144.1, C148.2, J49.3, JP88.5, JP89.1, L10.1
AVDD10: C159.1, C163.2, J54.3, JP97.5, JP98.1, L11.1
AVDD11: C174.1, C178.2, J59.3, JP106.5, JP107.1, L12.1
B+: JP2.1, U1.10
B+1: JP13.1, U2.10
B+2: JP22.1, U9.10
B+3: JP31.1, U13.10
B+4: JP40.1, U17.10
B+5: JP49.1, U21.10
B+6: JP58.1, U25.10
B+7: JP67.1, U29.10
B+8: JP76.1, U33.10
B+9: JP85.1, U37.10
B+10: JP94.1, U41.10
B+11: JP103.1, U45.10
B-: JP2.2, U1.9
B-1: JP13.2, U2.9
B-2: JP22.2, U9.9
B-3: JP31.2, U13.9
B-4: JP40.2, U17.9
B-5: JP49.2, U21.9
B-6: JP58.2, U25.9
B-7: JP67.2, U29.9
B-8: JP76.2, U33.9
B-9: JP85.2, U37.9
B-10: JP94.2, U41.9
B-11: JP103.2, U45.9
D1: JP10.4, U8.15
D2: JP10.1, U8.16
D3: JP10.3, R20.2, U8.17
D4: JP20.4, U12.15
D5: JP20.1, U12.16
D6: JP20.3, R38.2, U12.17
D7: JP29.4, U16.15
D8: JP29.1, U16.16
D9: JP29.3, R56.2, U16.17
D10: JP38.4, U20.15
D11: JP5.4, U4.15
D12: JP5.1, U4.16
D13: JP5.3, R5.2, U4.17
D14: JP38.1, U20.16
D15: JP38.3, R74.2, U20.17
D16: JP47.4, U24.15
D17: JP47.1, U24.16
D18: JP47.3, R92.2, U24.17
D19: JP56.4, U28.15
D20: JP56.1, U28.16
D21: JP56.3, R110.2, U28.17
D22: JP65.4, U32.15
D23: JP65.1, U32.16
D24: JP65.3, R128.2, U32.17
D25: JP74.4, U36.15
D26: JP74.1, U36.16
D27: JP74.3, R146.2, U36.17
D28: JP83.4, U40.15
D29: JP83.1, U40.16
D30: JP83.3, R164.2, U40.17
D31: JP92.4, U44.15
D32: JP92.1, U44.16
D33: JP92.3, R182.2, U44.17
D34: JP101.4, U48.15
D35: JP101.1, U48.16
D36: JP101.3, R200.2, U48.17
DTR: C1.1, JP9.DTR, Q4.3, R18.1
DTR1: C17.1, JP14.DTR, Q8.3, R36.1
DTR2: C32.1, JP23.DTR, Q12.3, R54.1
DTR3: C47.1, JP32.DTR, Q16.3, R72.1
DTR4: C62.1, JP41.DTR, Q20.3, R90.1
DTR5: C77.1, JP50.DTR, Q24.3, R108.1
DTR6: C92.1, JP59.DTR, Q28.3, R126.1
DTR7: C107.1, JP68.DTR, Q32.3, R144.1
DTR8: C122.1, JP77.DTR, Q36.3, R162.1
DTR9: C137.1, JP86.DTR, Q40.3, R180.1
DTR10: C152.1, JP95.DTR, Q44.3, R198.1
DTR11: C167.1, JP104.DTR, Q48.3, R216.1
GND: C2.2, C3.2, C4.2, C5.2, C6.2, C7.2, C9.C, C10.2, C11.1, C12.1, C13.2, C14.2, C16.2, D3.C, J2.3, JP1.3, JP3.1, JP3.4, JP4.3, JP5.6, JP7.GND, JP9.CTS, JP9.GND, JP11.2, JP11.5, R17.1, S2.1, SJ2.1, U1.5, U1.14, U3.2, U4.3, U4.5, U4.21, U6.6, U6.16, Y2.2
GND1: C15.2, C18.2, C19.C, C20.2, C21.2, C23.2, C24.2, C25.2, C26.2, C27.1, C28.1, C29.2, C30.2, D6.C, J6.3, JP8.GND, JP10.6, JP12.3, JP14.CTS, JP14.GND, JP15.3, JP16.1, JP16.4, JP17.2, JP17.5, R34.1, S1.1, SJ1.1, U2.5, U2.14, U5.2, U7.6, U7.16, U8.3, U8.5, U8.21, Y1.2
GND2: C31.2, C33.2, C34.C, C35.2, C36.2, C38.2, C39.2, C40.2, C41.2, C42.1, C43.1, C44.2, C45.2, D9.C, J11.3, JP19.GND, JP20.6, JP21.3, JP23.CTS, JP23.GND, JP24.3, JP25.1, JP25.4, JP26.2, JP26.5, R52.1, S3.1, SJ3.1, U9.5, U9.14, U10.2, U11.6, U11.16, U12.3, U12.5, U12.21, Y3.2
GND3: C46.2, C48.2, C49.C, C50.2, C51.2, C53.2, C54.2, C55.2, C56.2, C57.1, C58.1, C59.2, C60.2, D12.C, J16.3, JP28.GND, JP29.6, JP30.3, JP32.CTS, JP32.GND, JP33.3, JP34.1, JP34.4, JP35.2, JP35.5, R70.1, S4.1, SJ4.1, U13.5, U13.14, U14.2, U15.6, U15.16, U16.3, U16.5, U16.21, Y4.2
GND4: C61.2, C63.2, C64.C, C65.2, C66.2, C68.2, C69.2, C70.2, C71.2, C72.1, C73.1, C74.2, C75.2, D15.C, J21.3, JP37.GND, JP38.6, JP39.3, JP41.CTS, JP41.GND, JP42.3, JP43.1, JP43.4, JP44.2, JP44.5, R88.1, S5.1, SJ5.1, U17.5, U17.14, U18.2, U19.6, U19.16, U20.3, U20.5, U20.21, Y5.2
GND5: C76.2, C78.2, C79.C, C80.2, C81.2, C83.2, C84.2, C85.2, C86.2, C87.1, C88.1, C89.2, C90.2, D18.C, J26.3, JP46.GND, JP47.6, JP48.3, JP50.CTS, JP50.GND, JP51.3, JP52.1, JP52.4, JP53.2, JP53.5, R106.1, S6.1, SJ6.1, U21.5, U21.14, U22.2, U23.6, U23.16, U24.3, U24.5, U24.21, Y6.2
GND6: C91.2, C93.2, C94.C, C95.2, C96.2, C98.2, C99.2, C100.2, C101.2, C102.1, C103.1, C104.2, C105.2, D21.C, J31.3, JP55.GND, JP56.6, JP57.3, JP59.CTS, JP59.GND, JP60.3, JP61.1, JP61.4, JP62.2, JP62.5, R124.1, S7.1, SJ7.1, U25.5, U25.14, U26.2, U27.6, U27.16, U28.3, U28.5, U28.21, Y7.2
GND7: C106.2, C108.2, C109.C, C110.2, C111.2, C113.2, C114.2, C115.2, C116.2, C117.1, C118.1, C119.2, C120.2, D24.C, J36.3, JP64.GND, JP65.6, JP66.3, JP68.CTS, JP68.GND, JP69.3, JP70.1, JP70.4, JP71.2, JP71.5, R142.1, S8.1, SJ8.1, U29.5, U29.14, U30.2, U31.6, U31.16, U32.3, U32.5, U32.21, Y8.2
GND8: C121.2, C123.2, C124.C, C125.2, C126.2, C128.2, C129.2, C130.2, C131.2, C132.1, C133.1, C134.2, C135.2, D27.C, J41.3, JP73.GND, JP74.6, JP75.3, JP77.CTS, JP77.GND, JP78.3, JP79.1, JP79.4, JP80.2, JP80.5, R160.1, S9.1, SJ9.1, U33.5, U33.14, U34.2, U35.6, U35.16, U36.3, U36.5, U36.21, Y9.2
GND9: C136.2, C138.2, C139.C, C140.2, C141.2, C143.2, C144.2, C145.2, C146.2, C147.1, C148.1, C149.2, C150.2, D30.C, J46.3, JP82.GND, JP83.6, JP84.3, JP86.CTS, JP86.GND, JP87.3, JP88.1, JP88.4, JP89.2, JP89.5, R178.1, S10.1, SJ10.1, U37.5, U37.14, U38.2, U39.6, U39.16, U40.3, U40.5, U40.21, Y10.2
GND10: C151.2, C153.2, C154.C, C155.2, C156.2, C158.2, C159.2, C160.2, C161.2, C162.1, C163.1, C164.2, C165.2, D33.C, J51.3, JP91.GND, JP92.6, JP93.3, JP95.CTS, JP95.GND, JP96.3, JP97.1, JP97.4, JP98.2, JP98.5, R196.1, S11.1, SJ11.1, U41.5, U41.14, U42.2, U43.6, U43.16, U44.3, U44.5, U44.21, Y11.2
GND11: C166.2, C168.2, C169.C, C170.2, C171.2, C173.2, C174.2, C175.2, C176.2, C177.1, C178.1, C179.2, C180.2, D36.C, J56.3, JP100.GND, JP101.6, JP102.3, JP104.CTS, JP104.GND, JP105.3, JP106.1, JP106.4, JP107.2, JP107.5, R214.1, S12.1, SJ12.1, U45.5, U45.14, U46.2, U47.6, U47.16, U48.3, U48.5, U48.21, Y12.2
LC_DOUT: U1.12, U4.32
LC_DOUT1: U2.12, U8.32
LC_DOUT2: U9.12, U12.32
LC_DOUT3: U13.12, U16.32
LC_DOUT4: U17.12, U20.32
LC_DOUT5: U21.12, U24.32
LC_DOUT6: U25.12, U28.32
LC_DOUT7: U29.12, U32.32
LC_DOUT8: U33.12, U36.32
LC_DOUT9: U37.12, U40.32
LC_DOUT10: U41.12, U44.32
LC_DOUT11: U45.12, U48.32
LC_SCK: U1.11, U4.1
LC_SCK1: U2.11, U8.1
LC_SCK2: U9.11, U12.1
LC_SCK3: U13.11, U16.1
LC_SCK4: U17.11, U20.1
LC_SCK5: U21.11, U24.1
LC_SCK6: U25.11, U28.1
LC_SCK7: U29.11, U32.1
LC_SCK8: U33.11, U36.1
LC_SCK9: U37.11, U40.1
LC_SCK10: U41.11, U44.1
LC_SCK11: U45.11, U48.1
LV_SCL: Q2.2, R8.1, U3.1
LV_SCL1: Q6.2, R26.1, U5.1
LV_SCL2: Q10.2, R44.1, U10.1
LV_SCL3: Q14.2, R62.1, U14.1
LV_SCL4: Q18.2, R80.1, U18.1
LV_SCL5: Q22.2, R98.1, U22.1
LV_SCL6: Q26.2, R116.1, U26.1
LV_SCL7: Q30.2, R134.1, U30.1
LV_SCL8: Q34.2, R152.1, U34.1
LV_SCL9: Q38.2, R170.1, U38.1
LV_SCL10: Q42.2, R188.1, U42.1
LV_SCL11: Q46.2, R206.1, U46.1
LV_SDA: Q1.2, R9.1, U3.6
LV_SDA1: Q5.2, R27.1, U5.6
LV_SDA2: Q9.2, R45.1, U10.6
LV_SDA3: Q13.2, R63.1, U14.6
LV_SDA4: Q17.2, R81.1, U18.6
LV_SDA5: Q21.2, R99.1, U22.6
LV_SDA6: Q25.2, R117.1, U26.6
LV_SDA7: Q29.2, R135.1, U30.6
LV_SDA8: Q33.2, R153.1, U34.6
LV_SDA9: Q37.2, R171.1, U38.6
LV_SDA10: Q41.2, R189.1, U42.6
LV_SDA11: Q45.2, R207.1, U46.6
unnamed: U4.7, Y2.1
unnamed: D3.A, R5.1
unnamed: U4.8, Y2.3
unnamed: C5.1, JP7.D-, R6.1
unnamed: D1.A, R13.1
unnamed: D2.A, R15.1
unnamed: C2.1, JP7.D+, R1.1
unnamed: R6.2, U6.12
unnamed: R7.1, SJ2.2, U1.15
unnamed: C8.1, R3.2, U1.7
unnamed: C8.2, R4.2, U1.8
unnamed: C14.1, F1.1, JP7.VBUS
unnamed: R1.2, U6.11
unnamed: R12.2, U6.4
unnamed: JP6.3, U1.16
unnamed: R11.2, U6.20
unnamed: Q3.1, U1.2
unnamed: R16.1, R17.2, U1.4
unnamed: J1.1, JP6.1
unnamed: J2.2, J3.2
unnamed: C11.2, U1.6
unnamed: J2.1, J4.1
unnamed: J3.1, J5.1
unnamed: Q4.2, R10.1, U6.1
unnamed: D6.A, R20.1
unnamed: U8.7, Y1.1
unnamed: U8.8, Y1.3
unnamed: D4.A, R21.1
unnamed: D5.A, R22.1
unnamed: R25.1, SJ1.2, U2.15
unnamed: C22.1, R23.2, U2.7
unnamed: C22.2, R24.2, U2.8
unnamed: C30.1, F2.1, JP8.VBUS
unnamed: C26.1, JP8.D-, R29.1
unnamed: C25.1, JP8.D+, R28.1
unnamed: R29.2, U7.12
unnamed: R28.2, U7.11
unnamed: R30.2, U7.20
unnamed: Q7.1, U2.2
unnamed: R33.1, R34.2, U2.4
unnamed: C27.2, U2.6
unnamed: J6.2, J7.2
unnamed: J6.1, J8.1
unnamed: J7.1, J9.1
unnamed: J10.1, JP18.1
unnamed: JP18.3, U2.16
unnamed: R31.2, U7.4
unnamed: Q8.2, R35.1, U7.1
unnamed: D9.A, R38.1
unnamed: U12.7, Y3.1
unnamed: U12.8, Y3.3
unnamed: D7.A, R39.1
unnamed: D8.A, R40.1
unnamed: R43.1, SJ3.2, U9.15
unnamed: C37.1, R41.2, U9.7
unnamed: C37.2, R42.2, U9.8
unnamed: C45.1, F3.1, JP19.VBUS
unnamed: C41.1, JP19.D-, R47.1
unnamed: C40.1, JP19.D+, R46.1
unnamed: R47.2, U11.12
unnamed: R46.2, U11.11
unnamed: R48.2, U11.20
unnamed: Q11.1, U9.2
unnamed: R51.1, R52.2, U9.4
unnamed: C42.2, U9.6
unnamed: J11.2, J12.2
unnamed: J11.1, J13.1
unnamed: J12.1, J14.1
unnamed: J15.1, JP27.1
unnamed: JP27.3, U9.16
unnamed: R49.2, U11.4
unnamed: Q12.2, R53.1, U11.1
unnamed: D12.A, R56.1
unnamed: U16.7, Y4.1
unnamed: U16.8, Y4.3
unnamed: D10.A, R57.1
unnamed: D11.A, R58.1
unnamed: R61.1, SJ4.2, U13.15
unnamed: C52.1, R59.2, U13.7
unnamed: C52.2, R60.2, U13.8
unnamed: C60.1, F4.1, JP28.VBUS
unnamed: C56.1, JP28.D-, R65.1
unnamed: C55.1, JP28.D+, R64.1
unnamed: R65.2, U15.12
unnamed: R64.2, U15.11
unnamed: R66.2, U15.20
unnamed: Q15.1, U13.2
unnamed: R69.1, R70.2, U13.4
unnamed: C57.2, U13.6
unnamed: J16.2, J17.2
unnamed: J16.1, J18.1
unnamed: J17.1, J19.1
unnamed: J20.1, JP36.1
unnamed: JP36.3, U13.16
unnamed: R67.2, U15.4
unnamed: Q16.2, R71.1, U15.1
unnamed: D15.A, R74.1
unnamed: U20.7, Y5.1
unnamed: U20.8, Y5.3
unnamed: D13.A, R75.1
unnamed: D14.A, R76.1
unnamed: R79.1, SJ5.2, U17.15
unnamed: C67.1, R77.2, U17.7
unnamed: C67.2, R78.2, U17.8
unnamed: C75.1, F5.1, JP37.VBUS
unnamed: C71.1, JP37.D-, R83.1
unnamed: C70.1, JP37.D+, R82.1
unnamed: R83.2, U19.12
unnamed: R82.2, U19.11
unnamed: R84.2, U19.20
unnamed: Q19.1, U17.2
unnamed: R87.1, R88.2, U17.4
unnamed: C72.2, U17.6
unnamed: J21.2, J22.2
unnamed: J21.1, J23.1
unnamed: J22.1, J24.1
unnamed: J25.1, JP45.1
unnamed: JP45.3, U17.16
unnamed: R85.2, U19.4
unnamed: Q20.2, R89.1, U19.1
unnamed: D18.A, R92.1
unnamed: U24.7, Y6.1
unnamed: U24.8, Y6.3
unnamed: D16.A, R93.1
unnamed: D17.A, R94.1
unnamed: R97.1, SJ6.2, U21.15
unnamed: C82.1, R95.2, U21.7
unnamed: C82.2, R96.2, U21.8
unnamed: C90.1, F6.1, JP46.VBUS
unnamed: C86.1, JP46.D-, R101.1
unnamed: C85.1, JP46.D+, R100.1
unnamed: R101.2, U23.12
unnamed: R100.2, U23.11
unnamed: R102.2, U23.20
unnamed: Q23.1, U21.2
unnamed: R105.1, R106.2, U21.4
unnamed: C87.2, U21.6
unnamed: J26.2, J27.2
unnamed: J26.1, J28.1
unnamed: J27.1, J29.1
unnamed: J30.1, JP54.1
unnamed: JP54.3, U21.16
unnamed: R103.2, U23.4
unnamed: Q24.2, R107.1, U23.1
unnamed: D21.A, R110.1
unnamed: U28.7, Y7.1
unnamed: U28.8, Y7.3
unnamed: D19.A, R111.1
unnamed: D20.A, R112.1
unnamed: R115.1, SJ7.2, U25.15
unnamed: C97.1, R113.2, U25.7
unnamed: C97.2, R114.2, U25.8
unnamed: C105.1, F7.1, JP55.VBUS
unnamed: C101.1, JP55.D-, R119.1
unnamed: C100.1, JP55.D+, R118.1
unnamed: R119.2, U27.12
unnamed: R118.2, U27.11
unnamed: R120.2, U27.20
unnamed: Q27.1, U25.2
unnamed: R123.1, R124.2, U25.4
unnamed: C102.2, U25.6
unnamed: J31.2, J32.2
unnamed: J31.1, J33.1
unnamed: J32.1, J34.1
unnamed: J35.1, JP63.1
unnamed: JP63.3, U25.16
unnamed: R121.2, U27.4
unnamed: Q28.2, R125.1, U27.1
unnamed: D24.A, R128.1
unnamed: U32.7, Y8.1
unnamed: U32.8, Y8.3
unnamed: D22.A, R129.1
unnamed: D23.A, R130.1
unnamed: R133.1, SJ8.2, U29.15
unnamed: C112.1, R131.2, U29.7
unnamed: C112.2, R132.2, U29.8
unnamed: C120.1, F8.1, JP64.VBUS
unnamed: C116.1, JP64.D-, R137.1
unnamed: C115.1, JP64.D+, R136.1
unnamed: R137.2, U31.12
unnamed: R136.2, U31.11
unnamed: R138.2, U31.20
unnamed: Q31.1, U29.2
unnamed: R141.1, R142.2, U29.4
unnamed: C117.2, U29.6
unnamed: J36.2, J37.2
unnamed: J36.1, J38.1
unnamed: J37.1, J39.1
unnamed: J40.1, JP72.1
unnamed: JP72.3, U29.16
unnamed: R139.2, U31.4
unnamed: Q32.2, R143.1, U31.1
unnamed: D27.A, R146.1
unnamed: U36.7, Y9.1
unnamed: U36.8, Y9.3
unnamed: D25.A, R147.1
unnamed: D26.A, R148.1
unnamed: R151.1, SJ9.2, U33.15
unnamed: C127.1, R149.2, U33.7
unnamed: C127.2, R150.2, U33.8
unnamed: C135.1, F9.1, JP73.VBUS
unnamed: C131.1, JP73.D-, R155.1
unnamed: C130.1, JP73.D+, R154.1
unnamed: R155.2, U35.12
unnamed: R154.2, U35.11
unnamed: R156.2, U35.20
unnamed: Q35.1, U33.2
unnamed: R159.1, R160.2, U33.4
unnamed: C132.2, U33.6
unnamed: J41.2, J42.2
unnamed: J41.1, J43.1
unnamed: J42.1, J44.1
unnamed: J45.1, JP81.1
unnamed: JP81.3, U33.16
unnamed: R157.2, U35.4
unnamed: Q36.2, R161.1, U35.1
unnamed: D30.A, R164.1
unnamed: U40.7, Y10.1
unnamed: U40.8, Y10.3
unnamed: D28.A, R165.1
unnamed: D29.A, R166.1
unnamed: R169.1, SJ10.2, U37.15
unnamed: C142.1, R167.2, U37.7
unnamed: C142.2, R168.2, U37.8
unnamed: C150.1, F10.1, JP82.VBUS
unnamed: C146.1, JP82.D-, R173.1
unnamed: C145.1, JP82.D+, R172.1
unnamed: R173.2, U39.12
unnamed: R172.2, U39.11
unnamed: R174.2, U39.20
unnamed: Q39.1, U37.2
unnamed: R177.1, R178.2, U37.4
unnamed: C147.2, U37.6
unnamed: J46.2, J47.2
unnamed: J46.1, J48.1
unnamed: J47.1, J49.1
unnamed: J50.1, JP90.1
unnamed: JP90.3, U37.16
unnamed: R175.2, U39.4
unnamed: Q40.2, R179.1, U39.1
unnamed: D33.A, R182.1
unnamed: U44.7, Y11.1
unnamed: U44.8, Y11.3
unnamed: D31.A, R183.1
unnamed: D32.A, R184.1
unnamed: R187.1, SJ11.2, U41.15
unnamed: C157.1, R185.2, U41.7
unnamed: C157.2, R186.2, U41.8
unnamed: C165.1, F11.1, JP91.VBUS
unnamed: C161.1, JP91.D-, R191.1
unnamed: C160.1, JP91.D+, R190.1
unnamed: R191.2, U43.12
unnamed: R190.2, U43.11
unnamed: R192.2, U43.20
unnamed: Q43.1, U41.2
unnamed: R195.1, R196.2, U41.4
unnamed: C162.2, U41.6
unnamed: J51.2, J52.2
unnamed: J51.1, J53.1
unnamed: J52.1, J54.1
unnamed: J55.1, JP99.1
unnamed: JP99.3, U41.16
unnamed: R193.2, U43.4
unnamed: Q44.2, R197.1, U43.1
unnamed: D36.A, R200.1
unnamed: U48.7, Y12.1
unnamed: U48.8, Y12.3
unnamed: D34.A, R201.1
unnamed: D35.A, R202.1
unnamed: R205.1, SJ12.2, U45.15
unnamed: C172.1, R203.2, U45.7
unnamed: C172.2, R204.2, U45.8
unnamed: C180.1, F12.1, JP100.VBUS
unnamed: C176.1, JP100.D-, R209.1
unnamed: C175.1, JP100.D+, R208.1
unnamed: R209.2, U47.12
unnamed: R208.2, U47.11
unnamed: R210.2, U47.20
unnamed: Q47.1, U45.2
unnamed: R213.1, R214.2, U45.4
unnamed: C177.2, U45.6
unnamed: J56.2, J57.2
unnamed: J56.1, J58.1
unnamed: J57.1, J59.1
unnamed: J60.1, JP108.1
unnamed: JP108.3, U45.16
unnamed: R211.2, U47.4
unnamed: Q48.2, R215.1, U47.1
RIPUP@: L1.2, Q3.3, R16.2, U1.3
RIPUP@1: L2.2, Q7.3, R33.2, U2.3
RIPUP@2: L3.2, Q11.3, R51.2, U9.3
RIPUP@3: L4.2, Q15.3, R69.2, U13.3
RIPUP@4: L5.2, Q19.3, R87.2, U17.3
RIPUP@5: L6.2, Q23.3, R105.2, U21.3
RIPUP@6: L7.2, Q27.3, R123.2, U25.3
RIPUP@7: L8.2, Q31.3, R141.2, U29.3
RIPUP@8: L9.2, Q35.3, R159.2, U33.3
RIPUP@9: L10.2, Q39.3, R177.2, U37.3
RIPUP@10: L11.2, Q43.3, R195.2, U41.3
RIPUP@11: L12.2, Q47.3, R213.2, U45.3
RST: C1.2, JP5.5, R2.1, S2.3, U4.29
RST1: C17.2, JP10.5, R19.1, S1.3, U8.29
RST2: C32.2, JP20.5, R37.1, S3.3, U12.29
RST3: C47.2, JP29.5, R55.1, S4.3, U16.29
RST4: C62.2, JP38.5, R73.1, S5.3, U20.29
RST5: C77.2, JP47.5, R91.1, S6.3, U24.29
RST6: C92.2, JP56.5, R109.1, S7.3, U28.29
RST7: C107.2, JP65.5, R127.1, S8.3, U32.29
RST8: C122.2, JP74.5, R145.1, S9.3, U36.29
RST9: C137.2, JP83.5, R163.1, S10.3, U40.29
RST10: C152.2, JP92.5, R181.1, S11.3, U44.29
RST11: C167.2, JP101.5, R199.1, S12.3, U48.29
RXD: JP9.TXO, R11.1, U4.30
RXD1: JP14.TXO, R30.1, U8.30
RXD2: JP23.TXO, R48.1, U12.30
RXD3: JP32.TXO, R66.1, U16.30
RXD4: JP41.TXO, R84.1, U20.30
RXD5: JP50.TXO, R102.1, U24.30
RXD6: JP59.TXO, R120.1, U28.30
RXD7: JP68.TXO, R138.1, U32.30
RXD8: JP77.TXO, R156.1, U36.30
RXD9: JP86.TXO, R174.1, U40.30
RXD10: JP95.TXO, R192.1, U44.30
RXD11: JP104.TXO, R210.1, U48.30
RXLED: D1.C, U6.17
RXLED1: D4.C, U7.17
RXLED2: D7.C, U11.17
RXLED3: D10.C, U15.17
RXLED4: D13.C, U19.17
RXLED5: D16.C, U23.17
RXLED6: D19.C, U27.17
RXLED7: D22.C, U31.17
RXLED8: D25.C, U35.17
RXLED9: D28.C, U39.17
RXLED10: D31.C, U43.17
RXLED11: D34.C, U47.17
SCL: Q2.3, U4.28
SCL1: Q6.3, U8.28
SCL2: Q10.3, U12.28
SCL3: Q14.3, U16.28
SCL4: Q18.3, U20.28
SCL5: Q22.3, U24.28
SCL6: Q26.3, U28.28
SCL7: Q30.3, U32.28
SCL8: Q34.3, U36.28
SCL9: Q38.3, U40.28
SCL10: Q42.3, U44.28
SCL11: Q46.3, U48.28
SDA: Q1.3, U4.27
SDA1: Q5.3, U8.27
SDA2: Q9.3, U12.27
SDA3: Q13.3, U16.27
SDA4: Q17.3, U20.27
SDA5: Q21.3, U24.27
SDA6: Q25.3, U28.27
SDA7: Q29.3, U32.27
SDA8: Q33.3, U36.27
SDA9: Q37.3, U40.27
SDA10: Q41.3, U44.27
SDA11: Q45.3, U48.27
TEMP_DAT: JP1.2, JP4.2, R14.1, U4.2
TEMP_DAT1: JP12.2, JP15.2, R32.1, U8.2
TEMP_DAT2: JP21.2, JP24.2, R50.1, U12.2
TEMP_DAT3: JP30.2, JP33.2, R68.1, U16.2
TEMP_DAT4: JP39.2, JP42.2, R86.1, U20.2
TEMP_DAT5: JP48.2, JP51.2, R104.1, U24.2
TEMP_DAT6: JP57.2, JP60.2, R122.1, U28.2
TEMP_DAT7: JP66.2, JP69.2, R140.1, U32.2
TEMP_DAT8: JP75.2, JP78.2, R158.1, U36.2
TEMP_DAT9: JP84.2, JP87.2, R176.1, U40.2
TEMP_DAT10: JP93.2, JP96.2, R194.1, U44.2
TEMP_DAT11: JP102.2, JP105.2, R212.1, U48.2
TXD: JP9.RXI, R12.1, U4.31
TXD1: JP14.RXI, R31.1, U8.31
TXD2: JP23.RXI, R49.1, U12.31
TXD3: JP32.RXI, R67.1, U16.31
TXD4: JP41.RXI, R85.1, U20.31
TXD5: JP50.RXI, R103.1, U24.31
TXD6: JP59.RXI, R121.1, U28.31
TXD7: JP68.RXI, R139.1, U32.31
TXD8: JP77.RXI, R157.1, U36.31
TXD9: JP86.RXI, R175.1, U40.31
TXD10: JP95.RXI, R193.1, U44.31
TXD11: JP104.RXI, R211.1, U48.31
TXLED: D2.C, U6.10
TXLED1: D5.C, U7.10
TXLED2: D8.C, U11.10
TXLED3: D11.C, U15.10
TXLED4: D14.C, U19.10
TXLED5: D17.C, U23.10
TXLED6: D20.C, U27.10
TXLED7: D23.C, U31.10
TXLED8: D26.C, U35.10
TXLED9: D29.C, U39.10
TXLED10: D32.C, U43.10
TXLED11: D35.C, U47.10
