Borgesvpm/Amaze/(commit log)

2020-11-12 v.1.1
    Added wiring of figure on Illustrator
2020-11-16 CAD files
    [hook ladder.dwg, hook ladder.dxf]
2020-11-23 Python script for Raspberry Pi
2020-11-23 Openscale configure files
    [SparkFun_OpenScale_Panel_v10.brd, SparkFun_openScale.brd, SparkFun_openScale.sch, Untitled Sketch.fzz]
2020-11-25 Rotary encoder
2021-02-10 Add files via upload
    functional code before reset
    [0220082200D5DF_events.csv, 0220082200D5DF_weight.csv, Amaze_db.csv]
2021-02-12 Weight updated
    [0220082200D5DF_weight.csv]
2021-02-22 Illustrations Maze Schematic
2021-02-23 Deprecated code
    [0220082200D5DF_events.csv, 0220082200D5DF_weight.csv, Amaze_db.csv]
2021-02-26 current script
2021-02-26 Add files via upload
    commented BB correct 26.02.21
    [Tmaze_ARD_commented.ino]
2021-03-03 new data
    [189003_events.csv, 189003_weight.csv]
2021-03-09 Create Tmaze_ARD_clean210309
    this works with new Pi code and wiring for several animals.
2021-03-22 Add files via upload
    pirnt210322
    [Copy of Grand Bigery-Stantia.stl, Spectacular Blorr-Jaban(1).stl, Spectacular Blorr-Jaban.stl]
2021-06-21 Add files via upload
    latest version working on T-maze on 21.6.21 with new arduino Mega. Vini, could you restructure so the pin and port designations are first in the code for easy troubleshooting? Also commenting and optimizing readability would be greatly appreciated!
2021-06-21 Add files via upload
    arduino Mega code working on 21.6.21 on T-maze.
2022-05-05 Designação de classes
