Borgesvpm/Amaze/(notices)

Notices in the files:
3D printing/Ladder2.obj:
Exported from SketchUp, (c) 2000-2012 Trimble Navigation Limited
parts and their libraries:
SparkFun-Aesthetics: Licensing: CC v3.0 Share-Alike You are welcome to use this library for commercial purposes.
SparkFun-Resistors: Licensing: Creative Commons ShareAlike 4.0 International - https://creativecommons.org/licenses/by-sa/4.0
